aluisioalves123/rf-intercom/hardware/fabrication/assembly/00-overview.png

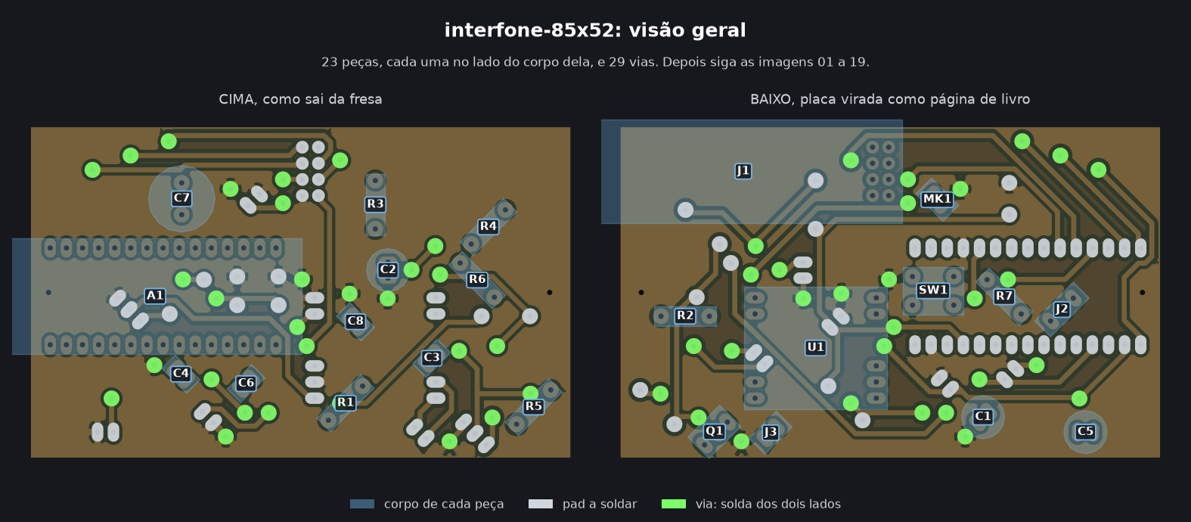
hardware/fabrication/assembly/00-overview.png
