aluisioalves123/rf-intercom/mechanical/stl/button.stl

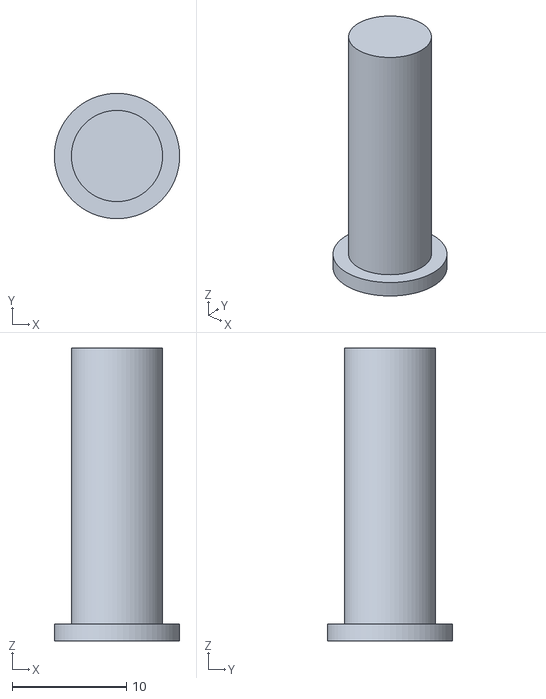
[picture p12: CAD file, 2026-10-19]
mechanical/stl/button.stl
11.0 x 11.0 x 25.7
