aluisioalves123/rf-intercom/mechanical/stl/knob.stl

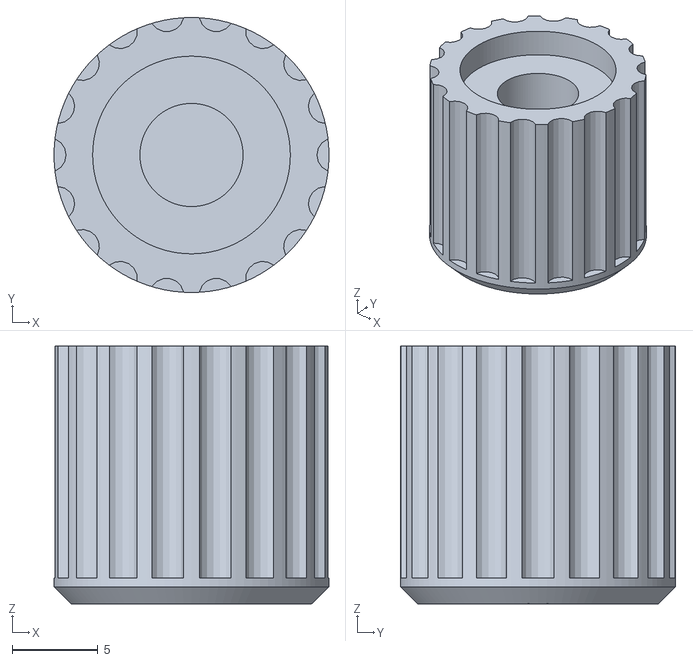
[picture p13: CAD file, 2026-10-19]
mechanical/stl/knob.stl
16.0 x 16.0 x 15.0
