aluisioalves123/rf-intercom/mechanical/stl/base.stl

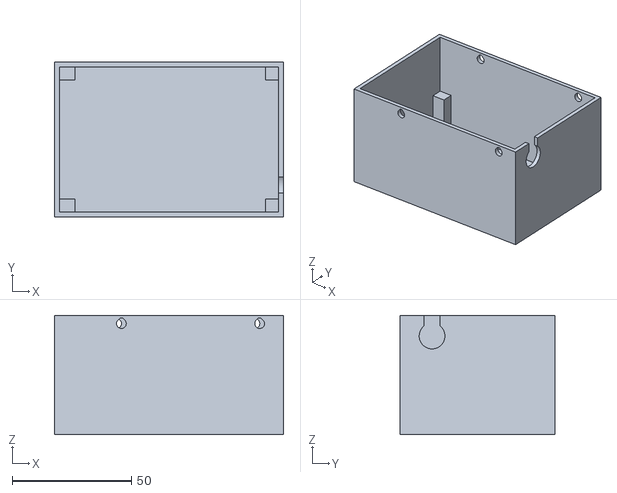
[picture p14: CAD file, 2026-10-19]
mechanical/stl/base.stl
96.1 x 65.0 x 50.1
