aluisioalves123/rf-intercom/mechanical/stl/lid.stl

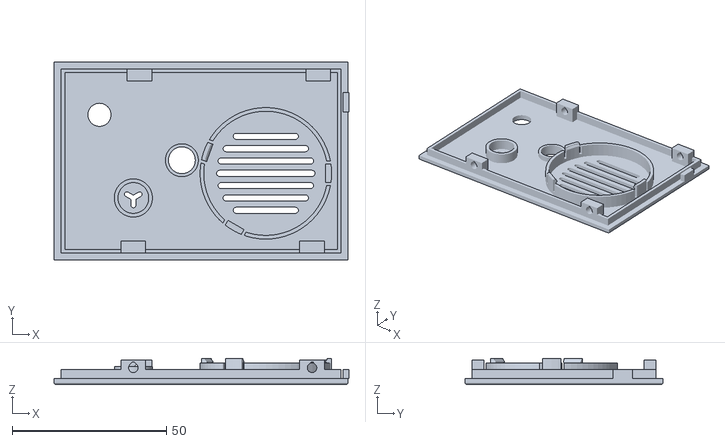
[picture p15: CAD file, 2026-10-19]
mechanical/stl/lid.stl
95.8 x 64.4 x 8.60
