aluisioalves123/rf-intercom/mechanical/pcb3d.scad

// 3D board generated from KiCad (simplified). Origin: bottom-left corner, B side at z = 0, F side at z = 1.6
RADIO_MODULE_HEIGHT = 18.0;
board_length = 85.00; board_width = 52.00; board_thickness = 1.6;
module pcb3d() {
  difference() {
    color("#1f5f2a") cube([board_length, board_width, board_thickness]);
    translate([31.45, 42.3, -1]) cylinder(d = 0.8, h = 4, $fn = 12);
    translate([38.6, 33.0, -1]) cylinder(d = 0.8, h = 4, $fn = 12);
    translate([36.06, 33.0, -1]) cylinder(d = 0.8, h = 4, $fn = 12);
    translate([33.52, 33.0, -1]) cylinder(d = 0.8, h = 4, $fn = 12);
    translate([30.98, 33.0, -1]) cylinder(d = 0.8, h = 4, $fn = 12);
    translate([28.44, 33.0, -1]) cylinder(d = 0.8, h = 4, $fn = 12);
    translate([25.9, 33.0, -1]) cylinder(d = 0.8, h = 4, $fn = 12);
    translate([23.36, 33.0, -1]) cylinder(d = 0.8, h = 4, $fn = 12);
    translate([20.82, 33.0, -1]) cylinder(d = 0.8, h = 4, $fn = 12);
    translate([18.28, 33.0, -1]) cylinder(d = 0.8, h = 4, $fn = 12);
    translate([15.74, 33.0, -1]) cylinder(d = 0.8, h = 4, $fn = 12);
    translate([13.2, 33.0, -1]) cylinder(d = 0.8, h = 4, $fn = 12);
    translate([10.66, 33.0, -1]) cylinder(d = 0.8, h = 4, $fn = 12);
    translate([8.12, 33.0, -1]) cylinder(d = 0.8, h = 4, $fn = 12);
    translate([5.58, 33.0, -1]) cylinder(d = 0.8, h = 4, $fn = 12);
    translate([3.04, 33.0, -1]) cylinder(d = 0.8, h = 4, $fn = 12);
    translate([3.04, 17.76, -1]) cylinder(d = 0.8, h = 4, $fn = 12);
    translate([5.58, 17.76, -1]) cylinder(d = 0.8, h = 4, $fn = 12);
    translate([8.12, 17.76, -1]) cylinder(d = 0.8, h = 4, $fn = 12);
    translate([10.66, 17.76, -1]) cylinder(d = 0.8, h = 4, $fn = 12);
    translate([13.2, 17.76, -1]) cylinder(d = 0.8, h = 4, $fn = 12);
    translate([15.74, 17.76, -1]) cylinder(d = 0.8, h = 4, $fn = 12);
    translate([18.28, 17.76, -1]) cylinder(d = 0.8, h = 4, $fn = 12);
    translate([20.82, 17.76, -1]) cylinder(d = 0.8, h = 4, $fn = 12);
    translate([23.36, 17.76, -1]) cylinder(d = 0.8, h = 4, $fn = 12);
    translate([25.9, 17.76, -1]) cylinder(d = 0.8, h = 4, $fn = 12);
    translate([28.44, 17.76, -1]) cylinder(d = 0.8, h = 4, $fn = 12);
    translate([30.98, 17.76, -1]) cylinder(d = 0.8, h = 4, $fn = 12);
    translate([33.52, 17.76, -1]) cylinder(d = 0.8, h = 4, $fn = 12);
    translate([36.06, 17.76, -1]) cylinder(d = 0.8, h = 4, $fn = 12);
    translate([38.6, 17.76, -1]) cylinder(d = 0.8, h = 4, $fn = 12);
    translate([2.775, 26.0, -1]) cylinder(d = 0.8, h = 4, $fn = 12);
    translate([23.75, 38.25, -1]) cylinder(d = 0.8, h = 4, $fn = 12);
    translate([23.75, 43.25, -1]) cylinder(d = 0.8, h = 4, $fn = 12);
    translate([74.75, 39.0, -1]) cylinder(d = 0.8, h = 4, $fn = 12);
    translate([69.362, 33.612, -1]) cylinder(d = 0.8, h = 4, $fn = 12);
    translate([62.25, 14.75, -1]) cylinder(d = 0.8, h = 4, $fn = 12);
    translate([64.018, 16.518, -1]) cylinder(d = 0.8, h = 4, $fn = 12);
    translate([19.45, 14.55, -1]) cylinder(d = 0.8, h = 4, $fn = 12);
    translate([33.0, 10.75, -1]) cylinder(d = 0.8, h = 4, $fn = 12);
    translate([34.768, 12.518, -1]) cylinder(d = 0.8, h = 4, $fn = 12);
    translate([73.0, 25.25, -1]) cylinder(d = 0.8, h = 4, $fn = 12);
    translate([67.612, 30.638, -1]) cylinder(d = 0.8, h = 4, $fn = 12);
    translate([65.95, 2.55, -1]) cylinder(d = 0.8, h = 4, $fn = 12);
    translate([54.25, 36.0, -1]) cylinder(d = 0.8, h = 4, $fn = 12);
    translate([54.25, 43.62, -1]) cylinder(d = 0.8, h = 4, $fn = 12);
    translate([56.25, 30.75, -1]) cylinder(d = 0.8, h = 4, $fn = 12);
    translate([56.25, 28.25, -1]) cylinder(d = 0.8, h = 4, $fn = 12);
    translate([81.725, 26.0, -1]) cylinder(d = 0.8, h = 4, $fn = 12);
    translate([50.2, 25.8, -1]) cylinder(d = 0.8, h = 4, $fn = 12);
    translate([30.7, 3.3, -1]) cylinder(d = 0.8, h = 4, $fn = 12);
    translate([24.5, 12.25, -1]) cylinder(d = 0.8, h = 4, $fn = 12);
    translate([22.732, 14.018, -1]) cylinder(d = 0.8, h = 4, $fn = 12);
    translate([52.25, 11.25, -1]) cylinder(d = 0.8, h = 4, $fn = 12);
    translate([46.862, 5.862, -1]) cylinder(d = 0.8, h = 4, $fn = 12);
    translate([56.2, 25.05, -1]) cylinder(d = 0.8, h = 4, $fn = 12);
    translate([76.5, 5.25, -1]) cylinder(d = 0.8, h = 4, $fn = 12);
    translate([81.888, 10.638, -1]) cylinder(d = 0.8, h = 4, $fn = 12);
    translate([42.7, 28.05, -1]) cylinder(d = 0.8, h = 4, $fn = 12);
    translate([52.0, 20.5, -1]) cylinder(d = 0.8, h = 4, $fn = 12);
    translate([50.232, 22.268, -1]) cylinder(d = 0.8, h = 4, $fn = 12);
    translate([32.5, 24.0, -1]) cylinder(d = 0.8, h = 4, $fn = 12);
    translate([39.0, 24.0, -1]) cylinder(d = 0.8, h = 4, $fn = 12);
    translate([32.5, 28.5, -1]) cylinder(d = 0.8, h = 4, $fn = 12);
    translate([39.0, 28.5, -1]) cylinder(d = 0.8, h = 4, $fn = 12);
    translate([71.0, 22.25, -1]) cylinder(d = 0.8, h = 4, $fn = 12);
    translate([78.62, 22.25, -1]) cylinder(d = 0.8, h = 4, $fn = 12);
    translate([71.75, 2.0, -1]) cylinder(d = 0.8, h = 4, $fn = 12);
    translate([69.954, 3.796, -1]) cylinder(d = 0.8, h = 4, $fn = 12);
    translate([68.158, 5.592, -1]) cylinder(d = 0.8, h = 4, $fn = 12);
    translate([27.25, 28.0, -1]) cylinder(d = 0.8, h = 4, $fn = 12);
    translate([21.862, 22.612, -1]) cylinder(d = 0.8, h = 4, $fn = 12);
    translate([44.7, 9.35, -1]) cylinder(d = 0.8, h = 4, $fn = 12);
    translate([44.7, 11.89, -1]) cylinder(d = 0.8, h = 4, $fn = 12);
    translate([44.7, 14.43, -1]) cylinder(d = 0.8, h = 4, $fn = 12);
    translate([44.7, 22.61, -1]) cylinder(d = 0.8, h = 4, $fn = 12);
    translate([44.7, 25.15, -1]) cylinder(d = 0.8, h = 4, $fn = 12);
    translate([63.8, 9.35, -1]) cylinder(d = 0.8, h = 4, $fn = 12);
    translate([63.8, 11.89, -1]) cylinder(d = 0.8, h = 4, $fn = 12);
    translate([63.8, 22.61, -1]) cylinder(d = 0.8, h = 4, $fn = 12);
    translate([63.8, 25.15, -1]) cylinder(d = 0.8, h = 4, $fn = 12);
    translate([17.25, 21.5, -1]) cylinder(d = 0.8, h = 4, $fn = 12);
    translate([15.454, 23.296, -1]) cylinder(d = 0.8, h = 4, $fn = 12);
    translate([13.658, 25.092, -1]) cylinder(d = 0.8, h = 4, $fn = 12);
    translate([13.0, 4.0, -1]) cylinder(d = 0.8, h = 4, $fn = 12);
    translate([10.5, 4.0, -1]) cylinder(d = 0.8, h = 4, $fn = 12);
    translate([42.75, 41.25, -1]) cylinder(d = 0.8, h = 4, $fn = 12);
    translate([45.29, 41.25, -1]) cylinder(d = 0.8, h = 4, $fn = 12);
    translate([42.75, 43.79, -1]) cylinder(d = 0.8, h = 4, $fn = 12);
    translate([45.29, 43.79, -1]) cylinder(d = 0.8, h = 4, $fn = 12);
    translate([42.75, 46.33, -1]) cylinder(d = 0.8, h = 4, $fn = 12);
    translate([45.29, 46.33, -1]) cylinder(d = 0.8, h = 4, $fn = 12);
    translate([42.75, 48.87, -1]) cylinder(d = 0.8, h = 4, $fn = 12);
    translate([45.29, 48.87, -1]) cylinder(d = 0.8, h = 4, $fn = 12);
    translate([27.0, 7.25, -1]) cylinder(d = 0.8, h = 4, $fn = 12);
    translate([28.768, 5.482, -1]) cylinder(d = 0.8, h = 4, $fn = 12);
    translate([36.0, 41.5, -1]) cylinder(d = 0.8, h = 4, $fn = 12);
    translate([34.204, 39.704, -1]) cylinder(d = 0.8, h = 4, $fn = 12);
    translate([62.25, 3.0, -1]) cylinder(d = 0.8, h = 4, $fn = 12);
    translate([60.454, 4.796, -1]) cylinder(d = 0.8, h = 4, $fn = 12);
    translate([29.2, 25.05, -1]) cylinder(d = 0.8, h = 4, $fn = 12);
    translate([39.7, 43.8, -1]) cylinder(d = 0.8, h = 4, $fn = 12);
    translate([48.7, 46.8, -1]) cylinder(d = 0.8, h = 4, $fn = 12);
    translate([23.95, 28.05, -1]) cylinder(d = 0.8, h = 4, $fn = 12);
    translate([21.7, 49.8, -1]) cylinder(d = 0.8, h = 4, $fn = 12);
    translate([15.7, 47.55, -1]) cylinder(d = 0.8, h = 4, $fn = 12);
    translate([9.7, 45.3, -1]) cylinder(d = 0.8, h = 4, $fn = 12);
    translate([43.45, 17.55, -1]) cylinder(d = 0.8, h = 4, $fn = 12);
    translate([12.7, 9.3, -1]) cylinder(d = 0.8, h = 4, $fn = 12);
    translate([33.7, 7.05, -1]) cylinder(d = 0.8, h = 4, $fn = 12);
    translate([28.45, 12.3, -1]) cylinder(d = 0.8, h = 4, $fn = 12);
    translate([41.95, 20.55, -1]) cylinder(d = 0.8, h = 4, $fn = 12);
    translate([59.95, 29.55, -1]) cylinder(d = 0.8, h = 4, $fn = 12);
    translate([63.7, 33.3, -1]) cylinder(d = 0.8, h = 4, $fn = 12);
    translate([72.7, 6.3, -1]) cylinder(d = 0.8, h = 4, $fn = 12);
    translate([73.45, 17.55, -1]) cylinder(d = 0.8, h = 4, $fn = 12);
    translate([64.45, 28.8, -1]) cylinder(d = 0.8, h = 4, $fn = 12);
    translate([39.7, 40.05, -1]) cylinder(d = 0.8, h = 4, $fn = 12);
    translate([78.7, 10.05, -1]) cylinder(d = 0.8, h = 4, $fn = 12);
    translate([67.45, 16.8, -1]) cylinder(d = 0.8, h = 4, $fn = 12);
    translate([37.45, 7.05, -1]) cylinder(d = 0.8, h = 4, $fn = 12);
    translate([48.7, 8.55, -1]) cylinder(d = 0.8, h = 4, $fn = 12);
  }
  color("#c98a3a") translate([0, 0, 1.6]) linear_extrude(0.04) union() {
    hull() { translate([35.95, 41.55]) circle(d = 0.8, $fn = 10); translate([35.65, 41.85]) circle(d = 0.8, $fn = 10); }
    hull() { translate([40.15, 37.5]) circle(d = 0.8, $fn = 10); translate([43.0, 40.35]) circle(d = 0.8, $fn = 10); }
    hull() { translate([3.1, 14.55]) circle(d = 0.8, $fn = 10); translate([19.45, 14.55]) circle(d = 0.8, $fn = 10); }
    hull() { translate([54.25, 20.25]) circle(d = 0.8, $fn = 10); translate([46.15, 12.15]) circle(d = 0.8, $fn = 10); }
    hull() { translate([65.95, 2.55]) circle(d = 0.8, $fn = 10); translate([67.75, 4.35]) circle(d = 0.8, $fn = 10); }
    hull() { translate([31.9, 25.05]) circle(d = 0.8, $fn = 10); translate([38.35, 25.05]) circle(d = 0.8, $fn = 10); }
    hull() { translate([29.2, 25.05]) circle(d = 0.8, $fn = 10); translate([31.9, 25.05]) circle(d = 0.8, $fn = 10); }
    hull() { translate([39.7, 43.8]) circle(d = 0.8, $fn = 10); translate([41.8, 43.8]) circle(d = 0.8, $fn = 10); }
    hull() { translate([48.7, 46.8]) circle(d = 0.8, $fn = 10); translate([46.15, 44.25]) circle(d = 0.8, $fn = 10); }
    hull() { translate([23.95, 28.05]) circle(d = 0.8, $fn = 10); translate([26.05, 28.05]) circle(d = 0.8, $fn = 10); }
    hull() { translate([46.9, 47.85]) circle(d = 0.8, $fn = 10); translate([46.0, 46.95]) circle(d = 0.8, $fn = 10); }
    hull() { translate([21.7, 49.8]) circle(d = 0.8, $fn = 10); translate([22.6, 50.7]) circle(d = 0.8, $fn = 10); }
    hull() { translate([46.15, 50.7]) circle(d = 0.8, $fn = 10); translate([47.2, 49.65]) circle(d = 0.8, $fn = 10); }
    hull() { translate([47.2, 48.3]) circle(d = 0.8, $fn = 10); translate([46.9, 48.0]) circle(d = 0.8, $fn = 10); }
    hull() { translate([22.6, 50.7]) circle(d = 0.8, $fn = 10); translate([46.15, 50.7]) circle(d = 0.8, $fn = 10); }
    hull() { translate([46.9, 48.0]) circle(d = 0.8, $fn = 10); translate([46.9, 47.85]) circle(d = 0.8, $fn = 10); }
    hull() { translate([47.2, 49.65]) circle(d = 0.8, $fn = 10); translate([47.2, 48.3]) circle(d = 0.8, $fn = 10); }
    hull() { translate([40.75, 47.55]) circle(d = 0.8, $fn = 10); translate([41.8, 48.6]) circle(d = 0.8, $fn = 10); }
    hull() { translate([15.7, 47.55]) circle(d = 0.8, $fn = 10); translate([40.75, 47.55]) circle(d = 0.8, $fn = 10); }
    hull() { translate([9.7, 45.3]) circle(d = 0.8, $fn = 10); translate([23.5, 45.3]) circle(d = 0.8, $fn = 10); }
    hull() { translate([23.5, 45.3]) circle(d = 0.8, $fn = 10); translate([24.25, 46.05]) circle(d = 0.8, $fn = 10); }
    hull() { translate([24.25, 46.05]) circle(d = 0.8, $fn = 10); translate([41.8, 46.05]) circle(d = 0.8, $fn = 10); }
    hull() { translate([12.7, 9.3]) circle(d = 0.8, $fn = 10); translate([12.7, 5.4]) circle(d = 0.8, $fn = 10); }
    hull() { translate([47.05, 21.15]) circle(d = 0.8, $fn = 10); translate([47.05, 39.0]) circle(d = 0.8, $fn = 10); }
    hull() { translate([47.05, 39.0]) circle(d = 0.8, $fn = 10); translate([45.7, 40.35]) circle(d = 0.8, $fn = 10); }
    hull() { translate([43.45, 17.55]) circle(d = 0.8, $fn = 10); translate([47.05, 21.15]) circle(d = 0.8, $fn = 10); }
    hull() { translate([28.45, 12.3]) circle(d = 0.8, $fn = 10); translate([33.7, 7.05]) circle(d = 0.8, $fn = 10); }
    hull() { translate([41.95, 20.55]) circle(d = 0.8, $fn = 10); translate([43.45, 22.05]) circle(d = 0.8, $fn = 10); }
    hull() { translate([63.7, 33.3]) circle(d = 0.8, $fn = 10); translate([59.95, 29.55]) circle(d = 0.8, $fn = 10); }
    hull() { translate([72.7, 6.3]) circle(d = 0.8, $fn = 10); translate([72.7, 3.15]) circle(d = 0.8, $fn = 10); }
    hull() { translate([72.7, 28.5]) circle(d = 0.8, $fn = 10); translate([64.75, 28.5]) circle(d = 0.8, $fn = 10); }
    hull() { translate([64.75, 28.5]) circle(d = 0.8, $fn = 10); translate([64.45, 28.8]) circle(d = 0.8, $fn = 10); }
    hull() { translate([38.95, 39.3]) circle(d = 0.8, $fn = 10); translate([35.5, 39.3]) circle(d = 0.8, $fn = 10); }
    hull() { translate([39.7, 40.05]) circle(d = 0.8, $fn = 10); translate([38.95, 39.3]) circle(d = 0.8, $fn = 10); }
    hull() { translate([77.65, 21.75]) circle(d = 0.8, $fn = 10); translate([73.45, 17.55]) circle(d = 0.8, $fn = 10); }
    hull() { translate([77.95, 23.25]) circle(d = 0.8, $fn = 10); translate([72.7, 28.5]) circle(d = 0.8, $fn = 10); }
    hull() { translate([70.3, 10.05]) circle(d = 0.8, $fn = 10); translate([78.7, 10.05]) circle(d = 0.8, $fn = 10); }
    hull() { translate([67.45, 16.8]) circle(d = 0.8, $fn = 10); translate([70.3, 13.95]) circle(d = 0.8, $fn = 10); }
    hull() { translate([70.3, 13.95]) circle(d = 0.8, $fn = 10); translate([70.3, 5.1]) circle(d = 0.8, $fn = 10); }
    hull() { translate([37.45, 7.05]) circle(d = 0.8, $fn = 10); translate([35.35, 4.95]) circle(d = 0.8, $fn = 10); }
    hull() { translate([29.95, 7.65]) circle(d = 0.8, $fn = 10); translate([28.3, 7.65]) circle(d = 0.8, $fn = 10); }
    hull() { translate([52.75, 8.55]) circle(d = 0.8, $fn = 10); translate([48.7, 8.55]) circle(d = 0.8, $fn = 10); }
    hull() { translate([65.5, 21.3]) circle(d = 0.8, $fn = 10); translate([52.75, 8.55]) circle(d = 0.8, $fn = 10); }
    hull() { translate([35.35, 4.95]) circle(d = 0.8, $fn = 10); translate([32.65, 4.95]) circle(d = 0.8, $fn = 10); }
    hull() { translate([32.65, 4.95]) circle(d = 0.8, $fn = 10); translate([29.95, 7.65]) circle(d = 0.8, $fn = 10); }
    hull() { translate([70.3, 21.3]) circle(d = 0.8, $fn = 10); translate([65.5, 21.3]) circle(d = 0.8, $fn = 10); }
    hull() { translate([20.65, 22.35]) circle(d = 0.8, $fn = 10); translate([18.4, 22.35]) circle(d = 0.8, $fn = 10); }
    hull() { translate([43.45, 9.9]) circle(d = 0.8, $fn = 10); translate([40.45, 12.9]) circle(d = 0.8, $fn = 10); }
    hull() { translate([40.45, 19.05]) circle(d = 0.8, $fn = 10); translate([37.6, 21.9]) circle(d = 0.8, $fn = 10); }
    hull() { translate([17.65, 24.75]) circle(d = 0.8, $fn = 10); translate([16.75, 23.85]) circle(d = 0.8, $fn = 10); }
    hull() { translate([37.6, 21.9]) circle(d = 0.8, $fn = 10); translate([25.6, 21.9]) circle(d = 0.8, $fn = 10); }
    hull() { translate([22.75, 24.75]) circle(d = 0.8, $fn = 10); translate([17.65, 24.75]) circle(d = 0.8, $fn = 10); }
    hull() { translate([40.45, 12.9]) circle(d = 0.8, $fn = 10); translate([40.45, 19.05]) circle(d = 0.8, $fn = 10); }
    hull() { translate([25.6, 21.9]) circle(d = 0.8, $fn = 10); translate([22.75, 24.75]) circle(d = 0.8, $fn = 10); }
    hull() { translate([61.3, 7.05]) circle(d = 0.8, $fn = 10); translate([61.3, 6.0]) circle(d = 0.8, $fn = 10); }
    hull() { translate([62.8, 8.55]) circle(d = 0.8, $fn = 10); translate([61.3, 7.05]) circle(d = 0.8, $fn = 10); }
    hull() { translate([65.05, 11.4]) circle(d = 0.8, $fn = 10); translate([66.25, 10.2]) circle(d = 0.8, $fn = 10); }
    hull() { translate([66.25, 7.35]) circle(d = 0.8, $fn = 10); translate([63.1, 4.2]) circle(d = 0.8, $fn = 10); }
    hull() { translate([66.25, 10.2]) circle(d = 0.8, $fn = 10); translate([66.25, 7.35]) circle(d = 0.8, $fn = 10); }
    translate([31.45, 42.3]) circle(d = 2.5, $fn = 16);
    translate([38.6, 33.0]) rotate(-90.0) hull() { translate([0.6, 0]) circle(d = 1.8, $fn = 12); translate([-0.6, 0]) circle(d = 1.8, $fn = 12); }
    translate([36.06, 33.0]) rotate(-90.0) hull() { translate([0.6, 0]) circle(d = 1.8, $fn = 12); translate([-0.6, 0]) circle(d = 1.8, $fn = 12); }
    translate([33.52, 33.0]) rotate(-90.0) hull() { translate([0.6, 0]) circle(d = 1.8, $fn = 12); translate([-0.6, 0]) circle(d = 1.8, $fn = 12); }
    translate([30.98, 33.0]) rotate(-90.0) hull() { translate([0.6, 0]) circle(d = 1.8, $fn = 12); translate([-0.6, 0]) circle(d = 1.8, $fn = 12); }
    translate([28.44, 33.0]) rotate(-90.0) hull() { translate([0.6, 0]) circle(d = 1.8, $fn = 12); translate([-0.6, 0]) circle(d = 1.8, $fn = 12); }
    translate([25.9, 33.0]) rotate(-90.0) hull() { translate([0.6, 0]) circle(d = 1.8, $fn = 12); translate([-0.6, 0]) circle(d = 1.8, $fn = 12); }
    translate([23.36, 33.0]) rotate(-90.0) hull() { translate([0.6, 0]) circle(d = 1.8, $fn = 12); translate([-0.6, 0]) circle(d = 1.8, $fn = 12); }
    translate([20.82, 33.0]) rotate(-90.0) hull() { translate([0.6, 0]) circle(d = 1.8, $fn = 12); translate([-0.6, 0]) circle(d = 1.8, $fn = 12); }
    translate([18.28, 33.0]) rotate(-90.0) hull() { translate([0.6, 0]) circle(d = 1.8, $fn = 12); translate([-0.6, 0]) circle(d = 1.8, $fn = 12); }
    translate([15.74, 33.0]) rotate(-90.0) hull() { translate([0.6, 0]) circle(d = 1.8, $fn = 12); translate([-0.6, 0]) circle(d = 1.8, $fn = 12); }
    translate([13.2, 33.0]) rotate(-90.0) hull() { translate([0.6, 0]) circle(d = 1.8, $fn = 12); translate([-0.6, 0]) circle(d = 1.8, $fn = 12); }
    translate([10.66, 33.0]) rotate(-90.0) hull() { translate([0.6, 0]) circle(d = 1.8, $fn = 12); translate([-0.6, 0]) circle(d = 1.8, $fn = 12); }
    translate([8.12, 33.0]) rotate(-90.0) hull() { translate([0.6, 0]) circle(d = 1.8, $fn = 12); translate([-0.6, 0]) circle(d = 1.8, $fn = 12); }
    translate([5.58, 33.0]) rotate(-90.0) hull() { translate([0.6, 0]) circle(d = 1.8, $fn = 12); translate([-0.6, 0]) circle(d = 1.8, $fn = 12); }
    translate([3.04, 33.0]) rotate(-90.0) hull() { translate([0.6, 0]) circle(d = 1.8, $fn = 12); translate([-0.6, 0]) circle(d = 1.8, $fn = 12); }
    translate([3.04, 17.76]) rotate(-90.0) hull() { translate([0.6, 0]) circle(d = 1.8, $fn = 12); translate([-0.6, 0]) circle(d = 1.8, $fn = 12); }
    translate([5.58, 17.76]) rotate(-90.0) hull() { translate([0.6, 0]) circle(d = 1.8, $fn = 12); translate([-0.6, 0]) circle(d = 1.8, $fn = 12); }
    translate([8.12, 17.76]) rotate(-90.0) hull() { translate([0.6, 0]) circle(d = 1.8, $fn = 12); translate([-0.6, 0]) circle(d = 1.8, $fn = 12); }
    translate([10.66, 17.76]) rotate(-90.0) hull() { translate([0.6, 0]) circle(d = 1.8, $fn = 12); translate([-0.6, 0]) circle(d = 1.8, $fn = 12); }
    translate([13.2, 17.76]) rotate(-90.0) hull() { translate([0.6, 0]) circle(d = 1.8, $fn = 12); translate([-0.6, 0]) circle(d = 1.8, $fn = 12); }
    translate([15.74, 17.76]) rotate(-90.0) hull() { translate([0.6, 0]) circle(d = 1.8, $fn = 12); translate([-0.6, 0]) circle(d = 1.8, $fn = 12); }
    translate([18.28, 17.76]) rotate(-90.0) hull() { translate([0.6, 0]) circle(d = 1.8, $fn = 12); translate([-0.6, 0]) circle(d = 1.8, $fn = 12); }
    translate([20.82, 17.76]) rotate(-90.0) hull() { translate([0.6, 0]) circle(d = 1.8, $fn = 12); translate([-0.6, 0]) circle(d = 1.8, $fn = 12); }
    translate([23.36, 17.76]) rotate(-90.0) hull() { translate([0.6, 0]) circle(d = 1.8, $fn = 12); translate([-0.6, 0]) circle(d = 1.8, $fn = 12); }
    translate([25.9, 17.76]) rotate(-90.0) hull() { translate([0.6, 0]) circle(d = 1.8, $fn = 12); translate([-0.6, 0]) circle(d = 1.8, $fn = 12); }
    translate([28.44, 17.76]) rotate(-90.0) hull() { translate([0.6, 0]) circle(d = 1.8, $fn = 12); translate([-0.6, 0]) circle(d = 1.8, $fn = 12); }
    translate([30.98, 17.76]) rotate(-90.0) hull() { translate([0.6, 0]) circle(d = 1.8, $fn = 12); translate([-0.6, 0]) circle(d = 1.8, $fn = 12); }
    translate([33.52, 17.76]) rotate(-90.0) hull() { translate([0.6, 0]) circle(d = 1.8, $fn = 12); translate([-0.6, 0]) circle(d = 1.8, $fn = 12); }
    translate([36.06, 17.76]) rotate(-90.0) hull() { translate([0.6, 0]) circle(d = 1.8, $fn = 12); translate([-0.6, 0]) circle(d = 1.8, $fn = 12); }
    translate([38.6, 17.76]) rotate(-90.0) hull() { translate([0.6, 0]) circle(d = 1.8, $fn = 12); translate([-0.6, 0]) circle(d = 1.8, $fn = 12); }
    translate([2.775, 26.0]) circle(d = 0.8, $fn = 16);
    translate([23.75, 38.25]) circle(d = 2.5, $fn = 16);
    translate([23.75, 43.25]) circle(d = 2.5, $fn = 16);
    translate([74.75, 39.0]) circle(d = 2.5, $fn = 16);
    translate([69.362, 33.612]) circle(d = 2.5, $fn = 16);
    translate([62.25, 14.75]) rotate(45.0) hull() { translate([0, 0.6]) circle(d = 1.8, $fn = 12); translate([0, -0.6]) circle(d = 1.8, $fn = 12); }
    translate([64.018, 16.518]) rotate(45.0) hull() { translate([0, 0.6]) circle(d = 1.8, $fn = 12); translate([0, -0.6]) circle(d = 1.8, $fn = 12); }
    translate([19.45, 14.55]) circle(d = 2.5, $fn = 16);
    translate([33.0, 10.75]) rotate(45.0) hull() { translate([0, 0.6]) circle(d = 1.8, $fn = 12); translate([0, -0.6]) circle(d = 1.8, $fn = 12); }
    translate([34.768, 12.518]) rotate(45.0) hull() { translate([0, 0.6]) circle(d = 1.8, $fn = 12); translate([0, -0.6]) circle(d = 1.8, $fn = 12); }
    translate([73.0, 25.25]) circle(d = 2.5, $fn = 16);
    translate([67.612, 30.638]) circle(d = 2.5, $fn = 16);
    translate([65.95, 2.55]) circle(d = 2.5, $fn = 16);
    translate([54.25, 36.0]) circle(d = 2.5, $fn = 16);
    translate([54.25, 43.62]) circle(d = 2.5, $fn = 16);
    translate([56.25, 30.75]) rotate(-90.0) hull() { translate([0, 0.6]) circle(d = 1.8, $fn = 12); translate([0, -0.6]) circle(d = 1.8, $fn = 12); }
    translate([56.25, 28.25]) rotate(-90.0) hull() { translate([0, 0.6]) circle(d = 1.8, $fn = 12); translate([0, -0.6]) circle(d = 1.8, $fn = 12); }
    translate([81.725, 26.0]) circle(d = 0.8, $fn = 16);
    translate([50.2, 25.8]) circle(d = 2.5, $fn = 16);
    translate([30.7, 3.3]) circle(d = 2.5, $fn = 16);
    translate([24.5, 12.25]) rotate(135.0) hull() { translate([0, 0.6]) circle(d = 1.8, $fn = 12); translate([0, -0.6]) circle(d = 1.8, $fn = 12); }
    translate([22.732, 14.018]) rotate(135.0) hull() { translate([0, 0.6]) circle(d = 1.8, $fn = 12); translate([0, -0.6]) circle(d = 1.8, $fn = 12); }
    translate([52.25, 11.25]) circle(d = 2.5, $fn = 16);
    translate([46.862, 5.862]) circle(d = 2.5, $fn = 16);
    translate([56.2, 25.05]) circle(d = 2.5, $fn = 16);
    translate([76.5, 5.25]) circle(d = 2.5, $fn = 16);
    translate([81.888, 10.638]) circle(d = 2.5, $fn = 16);
    translate([42.7, 28.05]) circle(d = 2.5, $fn = 16);
    translate([52.0, 20.5]) rotate(135.0) hull() { translate([0, 0.6]) circle(d = 1.8, $fn = 12); translate([0, -0.6]) circle(d = 1.8, $fn = 12); }
    translate([50.232, 22.268]) rotate(135.0) hull() { translate([0, 0.6]) circle(d = 1.8, $fn = 12); translate([0, -0.6]) circle(d = 1.8, $fn = 12); }
    translate([32.5, 24.0]) circle(d = 2.5, $fn = 16);
    translate([39.0, 24.0]) circle(d = 2.5, $fn = 16);
    translate([32.5, 28.5]) circle(d = 2.5, $fn = 16);
    translate([39.0, 28.5]) circle(d = 2.5, $fn = 16);
    translate([71.0, 22.25]) circle(d = 2.5, $fn = 16);
    translate([78.62, 22.25]) circle(d = 2.5, $fn = 16);
    translate([71.75, 2.0]) rotate(135.0) hull() { translate([0, 0.6]) circle(d = 1.8, $fn = 12); translate([0, -0.6]) circle(d = 1.8, $fn = 12); }
    translate([69.954, 3.796]) rotate(135.0) hull() { translate([0, 0.6]) circle(d = 1.8, $fn = 12); translate([0, -0.6]) circle(d = 1.8, $fn = 12); }
    translate([68.158, 5.592]) rotate(135.0) hull() { translate([0, 0.6]) circle(d = 1.8, $fn = 12); translate([0, -0.6]) circle(d = 1.8, $fn = 12); }
    translate([27.25, 28.0]) circle(d = 2.5, $fn = 16);
    translate([21.862, 22.612]) circle(d = 2.5, $fn = 16);
    translate([44.7, 9.35]) rotate(90.0) hull() { translate([0, 0.6]) circle(d = 1.8, $fn = 12); translate([0, -0.6]) circle(d = 1.8, $fn = 12); }
    translate([44.7, 11.89]) rotate(90.0) hull() { translate([0, 0.6]) circle(d = 1.8, $fn = 12); translate([0, -0.6]) circle(d = 1.8, $fn = 12); }
    translate([44.7, 14.43]) rotate(90.0) hull() { translate([0, 0.6]) circle(d = 1.8, $fn = 12); translate([0, -0.6]) circle(d = 1.8, $fn = 12); }
    translate([44.7, 22.61]) rotate(90.0) hull() { translate([0, 0.6]) circle(d = 1.8, $fn = 12); translate([0, -0.6]) circle(d = 1.8, $fn = 12); }
    translate([44.7, 25.15]) rotate(90.0) hull() { translate([0, 0.6]) circle(d = 1.8, $fn = 12); translate([0, -0.6]) circle(d = 1.8, $fn = 12); }
    translate([63.8, 9.35]) rotate(90.0) hull() { translate([0, 0.6]) circle(d = 1.8, $fn = 12); translate([0, -0.6]) circle(d = 1.8, $fn = 12); }
    translate([63.8, 11.89]) rotate(90.0) hull() { translate([0, 0.6]) circle(d = 1.8, $fn = 12); translate([0, -0.6]) circle(d = 1.8, $fn = 12); }
    translate([63.8, 22.61]) rotate(90.0) hull() { translate([0, 0.6]) circle(d = 1.8, $fn = 12); translate([0, -0.6]) circle(d = 1.8, $fn = 12); }
    translate([63.8, 25.15]) rotate(90.0) hull() { translate([0, 0.6]) circle(d = 1.8, $fn = 12); translate([0, -0.6]) circle(d = 1.8, $fn = 12); }
    translate([17.25, 21.5]) rotate(45.0) hull() { translate([0.6, 0]) circle(d = 1.8, $fn = 12); translate([-0.6, 0]) circle(d = 1.8, $fn = 12); }
    translate([15.454, 23.296]) rotate(45.0) hull() { translate([0.6, 0]) circle(d = 1.8, $fn = 12); translate([-0.6, 0]) circle(d = 1.8, $fn = 12); }
    translate([13.658, 25.092]) rotate(45.0) hull() { translate([0.6, 0]) circle(d = 1.8, $fn = 12); translate([-0.6, 0]) circle(d = 1.8, $fn = 12); }
    translate([13.0, 4.0]) rotate(180.0) hull() { translate([0, 0.6]) circle(d = 1.8, $fn = 12); translate([0, -0.6]) circle(d = 1.8, $fn = 12); }
    translate([10.5, 4.0]) rotate(180.0) hull() { translate([0, 0.6]) circle(d = 1.8, $fn = 12); translate([0, -0.6]) circle(d = 1.8, $fn = 12); }
    translate([42.75, 41.25]) circle(d = 2.0, $fn = 16);
    translate([45.29, 41.25]) circle(d = 2.0, $fn = 16);
    translate([42.75, 43.79]) circle(d = 2.0, $fn = 16);
    translate([45.29, 43.79]) circle(d = 2.0, $fn = 16);
    translate([42.75, 46.33]) circle(d = 2.0, $fn = 16);
    translate([45.29, 46.33]) circle(d = 2.0, $fn = 16);
    translate([42.75, 48.87]) circle(d = 2.0, $fn = 16);
    translate([45.29, 48.87]) circle(d = 2.0, $fn = 16);
    translate([27.0, 7.25]) rotate(-45.0) hull() { translate([0, 0.6]) circle(d = 1.8, $fn = 12); translate([0, -0.6]) circle(d = 1.8, $fn = 12); }
    translate([28.768, 5.482]) rotate(-45.0) hull() { translate([0, 0.6]) circle(d = 1.8, $fn = 12); translate([0, -0.6]) circle(d = 1.8, $fn = 12); }
    translate([36.0, 41.5]) rotate(135.0) hull() { translate([0.6, 0]) circle(d = 1.8, $fn = 12); translate([-0.6, 0]) circle(d = 1.8, $fn = 12); }
    translate([34.204, 39.704]) rotate(135.0) hull() { translate([0.6, 0]) circle(d = 1.8, $fn = 12); translate([-0.6, 0]) circle(d = 1.8, $fn = 12); }
    translate([62.25, 3.0]) rotate(45.0) hull() { translate([0.6, 0]) circle(d = 1.8, $fn = 12); translate([-0.6, 0]) circle(d = 1.8, $fn = 12); }
    translate([60.454, 4.796]) rotate(45.0) hull() { translate([0.6, 0]) circle(d = 1.8, $fn = 12); translate([-0.6, 0]) circle(d = 1.8, $fn = 12); }
    translate([29.2, 25.05]) circle(d = 2.5, $fn = 12);
    translate([39.7, 43.8]) circle(d = 2.5, $fn = 12);
    translate([48.7, 46.8]) circle(d = 2.5, $fn = 12);
    translate([23.95, 28.05]) circle(d = 2.5, $fn = 12);
    translate([21.7, 49.8]) circle(d = 2.5, $fn = 12);
    translate([15.7, 47.55]) circle(d = 2.5, $fn = 12);
    translate([9.7, 45.3]) circle(d = 2.5, $fn = 12);
    translate([43.45, 17.55]) circle(d = 2.5, $fn = 12);
    translate([12.7, 9.3]) circle(d = 2.5, $fn = 12);
    translate([33.7, 7.05]) circle(d = 2.5, $fn = 12);
    translate([28.45, 12.3]) circle(d = 2.5, $fn = 12);
    translate([41.95, 20.55]) circle(d = 2.5, $fn = 12);
    translate([59.95, 29.55]) circle(d = 2.5, $fn = 12);
    translate([63.7, 33.3]) circle(d = 2.5, $fn = 12);
    translate([72.7, 6.3]) circle(d = 2.5, $fn = 12);
    translate([73.45, 17.55]) circle(d = 2.5, $fn = 12);
    translate([64.45, 28.8]) circle(d = 2.5, $fn = 12);
    translate([39.7, 40.05]) circle(d = 2.5, $fn = 12);
    translate([78.7, 10.05]) circle(d = 2.5, $fn = 12);
    translate([67.45, 16.8]) circle(d = 2.5, $fn = 12);
    translate([37.45, 7.05]) circle(d = 2.5, $fn = 12);
    translate([48.7, 8.55]) circle(d = 2.5, $fn = 12);
  }
  color("#c98a3a") translate([0, 0, -0.04]) linear_extrude(0.04) union() {
    hull() { translate([65.95, 2.7]) circle(d = 0.8, $fn = 10); translate([65.95, 2.55]) circle(d = 0.8, $fn = 10); }
    hull() { translate([56.2, 25.05]) circle(d = 0.8, $fn = 10); translate([56.2, 27.45]) circle(d = 0.8, $fn = 10); }
    hull() { translate([33.55, 14.55]) circle(d = 0.8, $fn = 10); translate([35.5, 16.5]) circle(d = 0.8, $fn = 10); }
    hull() { translate([19.45, 14.55]) circle(d = 0.8, $fn = 10); translate([33.55, 14.55]) circle(d = 0.8, $fn = 10); }
    hull() { translate([29.35, 25.2]) circle(d = 0.8, $fn = 10); translate([29.2, 25.05]) circle(d = 0.8, $fn = 10); }
    hull() { translate([28.9, 31.65]) circle(d = 0.8, $fn = 10); translate([29.35, 31.2]) circle(d = 0.8, $fn = 10); }
    hull() { translate([29.35, 31.2]) circle(d = 0.8, $fn = 10); translate([29.35, 25.2]) circle(d = 0.8, $fn = 10); }
    hull() { translate([22.9, 45.45]) circle(d = 0.8, $fn = 10); translate([38.05, 45.45]) circle(d = 0.8, $fn = 10); }
    hull() { translate([16.15, 34.35]) circle(d = 0.8, $fn = 10); translate([16.15, 38.7]) circle(d = 0.8, $fn = 10); }
    hull() { translate([38.05, 45.45]) circle(d = 0.8, $fn = 10); translate([39.7, 43.8]) circle(d = 0.8, $fn = 10); }
    hull() { translate([16.15, 38.7]) circle(d = 0.8, $fn = 10); translate([22.9, 45.45]) circle(d = 0.8, $fn = 10); }
    hull() { translate([48.7, 48.15]) circle(d = 0.8, $fn = 10); translate([48.7, 46.8]) circle(d = 0.8, $fn = 10); }
    hull() { translate([13.6, 34.35]) circle(d = 0.8, $fn = 10); translate([13.6, 37.95]) circle(d = 0.8, $fn = 10); }
    hull() { translate([26.35, 50.7]) circle(d = 0.8, $fn = 10); translate([46.15, 50.7]) circle(d = 0.8, $fn = 10); }
    hull() { translate([46.15, 50.7]) circle(d = 0.8, $fn = 10); translate([48.7, 48.15]) circle(d = 0.8, $fn = 10); }
    hull() { translate([13.6, 37.95]) circle(d = 0.8, $fn = 10); translate([26.35, 50.7]) circle(d = 0.8, $fn = 10); }
    hull() { translate([14.95, 28.05]) circle(d = 0.8, $fn = 10); translate([23.95, 28.05]) circle(d = 0.8, $fn = 10); }
    hull() { translate([11.2, 31.8]) circle(d = 0.8, $fn = 10); translate([14.95, 28.05]) circle(d = 0.8, $fn = 10); }
    hull() { translate([6.1, 34.2]) circle(d = 0.8, $fn = 10); translate([21.7, 49.8]) circle(d = 0.8, $fn = 10); }
    hull() { translate([3.4, 34.35]) circle(d = 0.8, $fn = 10); translate([3.4, 35.25]) circle(d = 0.8, $fn = 10); }
    hull() { translate([3.4, 35.25]) circle(d = 0.8, $fn = 10); translate([15.7, 47.55]) circle(d = 0.8, $fn = 10); }
    hull() { translate([5.65, 28.35]) circle(d = 0.8, $fn = 10); translate([3.4, 30.6]) circle(d = 0.8, $fn = 10); }
    hull() { translate([5.65, 21.6]) circle(d = 0.8, $fn = 10); translate([5.65, 28.35]) circle(d = 0.8, $fn = 10); }
    hull() { translate([1.3, 36.9]) circle(d = 0.8, $fn = 10); translate([9.7, 45.3]) circle(d = 0.8, $fn = 10); }
    hull() { translate([2.35, 30.6]) circle(d = 0.8, $fn = 10); translate([1.3, 31.65]) circle(d = 0.8, $fn = 10); }
    hull() { translate([3.4, 30.6]) circle(d = 0.8, $fn = 10); translate([2.35, 30.6]) circle(d = 0.8, $fn = 10); }
    hull() { translate([3.25, 19.2]) circle(d = 0.8, $fn = 10); translate([5.65, 21.6]) circle(d = 0.8, $fn = 10); }
    hull() { translate([1.3, 31.65]) circle(d = 0.8, $fn = 10); translate([1.3, 36.9]) circle(d = 0.8, $fn = 10); }
    hull() { translate([31.15, 10.35]) circle(d = 0.8, $fn = 10); translate([36.25, 10.35]) circle(d = 0.8, $fn = 10); }
    hull() { translate([36.25, 10.35]) circle(d = 0.8, $fn = 10); translate([43.45, 17.55]) circle(d = 0.8, $fn = 10); }
    hull() { translate([12.55, 9.45]) circle(d = 0.8, $fn = 10); translate([30.25, 9.45]) circle(d = 0.8, $fn = 10); }
    hull() { translate([5.65, 16.35]) circle(d = 0.8, $fn = 10); translate([12.7, 9.3]) circle(d = 0.8, $fn = 10); }
    hull() { translate([30.25, 9.45]) circle(d = 0.8, $fn = 10); translate([31.75, 10.95]) circle(d = 0.8, $fn = 10); }
    hull() { translate([65.65, 21.3]) circle(d = 0.8, $fn = 10); translate([67.0, 22.65]) circle(d = 0.8, $fn = 10); }
    hull() { translate([15.85, 11.85]) circle(d = 0.8, $fn = 10); translate([23.2, 11.85]) circle(d = 0.8, $fn = 10); }
    hull() { translate([37.0, 3.75]) circle(d = 0.8, $fn = 10); translate([47.95, 3.75]) circle(d = 0.8, $fn = 10); }
    hull() { translate([47.95, 3.75]) circle(d = 0.8, $fn = 10); translate([65.5, 21.3]) circle(d = 0.8, $fn = 10); }
    hull() { translate([65.5, 21.3]) circle(d = 0.8, $fn = 10); translate([65.65, 21.3]) circle(d = 0.8, $fn = 10); }
    hull() { translate([11.2, 16.5]) circle(d = 0.8, $fn = 10); translate([15.85, 11.85]) circle(d = 0.8, $fn = 10); }
    hull() { translate([67.0, 22.65]) circle(d = 0.8, $fn = 10); translate([67.0, 29.55]) circle(d = 0.8, $fn = 10); }
    hull() { translate([33.7, 7.05]) circle(d = 0.8, $fn = 10); translate([37.0, 3.75]) circle(d = 0.8, $fn = 10); }
    hull() { translate([28.0, 11.85]) circle(d = 0.8, $fn = 10); translate([28.45, 12.3]) circle(d = 0.8, $fn = 10); }
    hull() { translate([23.2, 11.85]) circle(d = 0.8, $fn = 10); translate([28.0, 11.85]) circle(d = 0.8, $fn = 10); }
    hull() { translate([42.4, 20.1]) circle(d = 0.8, $fn = 10); translate([50.8, 20.1]) circle(d = 0.8, $fn = 10); }
    hull() { translate([33.25, 20.55]) circle(d = 0.8, $fn = 10); translate([41.95, 20.55]) circle(d = 0.8, $fn = 10); }
    hull() { translate([53.65, 34.95]) circle(d = 0.8, $fn = 10); translate([51.1, 37.5]) circle(d = 0.8, $fn = 10); }
    hull() { translate([41.95, 20.55]) circle(d = 0.8, $fn = 10); translate([42.4, 20.1]) circle(d = 0.8, $fn = 10); }
    hull() { translate([53.65, 22.95]) circle(d = 0.8, $fn = 10); translate([53.65, 34.95]) circle(d = 0.8, $fn = 10); }
    hull() { translate([51.1, 37.5]) circle(d = 0.8, $fn = 10); translate([24.7, 37.5]) circle(d = 0.8, $fn = 10); }
    hull() { translate([31.6, 18.9]) circle(d = 0.8, $fn = 10); translate([33.25, 20.55]) circle(d = 0.8, $fn = 10); }
    hull() { translate([50.8, 20.1]) circle(d = 0.8, $fn = 10); translate([53.65, 22.95]) circle(d = 0.8, $fn = 10); }
    hull() { translate([50.8, 20.1]) circle(d = 0.8, $fn = 10); translate([50.8, 13.65]) circle(d = 0.8, $fn = 10); }
    hull() { translate([50.8, 13.65]) circle(d = 0.8, $fn = 10); translate([52.0, 12.45]) circle(d = 0.8, $fn = 10); }
    hull() { translate([59.95, 29.55]) circle(d = 0.8, $fn = 10); translate([58.75, 29.55]) circle(d = 0.8, $fn = 10); }
    hull() { translate([68.95, 38.55]) circle(d = 0.8, $fn = 10); translate([63.7, 33.3]) circle(d = 0.8, $fn = 10); }
    hull() { translate([73.6, 38.55]) circle(d = 0.8, $fn = 10); translate([68.95, 38.55]) circle(d = 0.8, $fn = 10); }
    hull() { translate([58.75, 29.55]) circle(d = 0.8, $fn = 10); translate([57.7, 30.6]) circle(d = 0.8, $fn = 10); }
    hull() { translate([64.0, 33.6]) circle(d = 0.8, $fn = 10); translate([54.85, 42.75]) circle(d = 0.8, $fn = 10); }
    hull() { translate([72.55, 26.4]) circle(d = 0.8, $fn = 10); translate([76.15, 22.8]) circle(d = 0.8, $fn = 10); }
    hull() { translate([76.15, 6.45]) circle(d = 0.8, $fn = 10); translate([72.85, 6.45]) circle(d = 0.8, $fn = 10); }
    hull() { translate([76.15, 22.8]) circle(d = 0.8, $fn = 10); translate([76.15, 6.45]) circle(d = 0.8, $fn = 10); }
    hull() { translate([70.0, 32.55]) circle(d = 0.8, $fn = 10); translate([70.0, 28.95]) circle(d = 0.8, $fn = 10); }
    hull() { translate([70.0, 28.95]) circle(d = 0.8, $fn = 10); translate([72.55, 26.4]) circle(d = 0.8, $fn = 10); }
    hull() { translate([72.85, 6.45]) circle(d = 0.8, $fn = 10); translate([72.7, 6.3]) circle(d = 0.8, $fn = 10); }
    hull() { translate([70.15, 14.25]) circle(d = 0.8, $fn = 10); translate([63.55, 14.25]) circle(d = 0.8, $fn = 10); }
    hull() { translate([40.45, 39.3]) circle(d = 0.8, $fn = 10); translate([39.7, 40.05]) circle(d = 0.8, $fn = 10); }
    hull() { translate([53.95, 39.3]) circle(d = 0.8, $fn = 10); translate([40.45, 39.3]) circle(d = 0.8, $fn = 10); }
    hull() { translate([64.45, 28.8]) circle(d = 0.8, $fn = 10); translate([53.95, 39.3]) circle(d = 0.8, $fn = 10); }
    hull() { translate([73.45, 17.55]) circle(d = 0.8, $fn = 10); translate([70.15, 14.25]) circle(d = 0.8, $fn = 10); }
    hull() { translate([64.9, 16.8]) circle(d = 0.8, $fn = 10); translate([67.45, 16.8]) circle(d = 0.8, $fn = 10); }
    hull() { translate([78.7, 10.05]) circle(d = 0.8, $fn = 10); translate([80.8, 10.05]) circle(d = 0.8, $fn = 10); }
    hull() { translate([47.2, 7.05]) circle(d = 0.8, $fn = 10); translate([37.45, 7.05]) circle(d = 0.8, $fn = 10); }
    hull() { translate([48.7, 8.55]) circle(d = 0.8, $fn = 10); translate([47.2, 7.05]) circle(d = 0.8, $fn = 10); }
    translate([31.45, 42.3]) circle(d = 2.5, $fn = 16);
    translate([38.6, 33.0]) rotate(-90.0) hull() { translate([0.6, 0]) circle(d = 1.8, $fn = 12); translate([-0.6, 0]) circle(d = 1.8, $fn = 12); }
    translate([36.06, 33.0]) rotate(-90.0) hull() { translate([0.6, 0]) circle(d = 1.8, $fn = 12); translate([-0.6, 0]) circle(d = 1.8, $fn = 12); }
    translate([33.52, 33.0]) rotate(-90.0) hull() { translate([0.6, 0]) circle(d = 1.8, $fn = 12); translate([-0.6, 0]) circle(d = 1.8, $fn = 12); }
    translate([30.98, 33.0]) rotate(-90.0) hull() { translate([0.6, 0]) circle(d = 1.8, $fn = 12); translate([-0.6, 0]) circle(d = 1.8, $fn = 12); }
    translate([28.44, 33.0]) rotate(-90.0) hull() { translate([0.6, 0]) circle(d = 1.8, $fn = 12); translate([-0.6, 0]) circle(d = 1.8, $fn = 12); }
    translate([25.9, 33.0]) rotate(-90.0) hull() { translate([0.6, 0]) circle(d = 1.8, $fn = 12); translate([-0.6, 0]) circle(d = 1.8, $fn = 12); }
    translate([23.36, 33.0]) rotate(-90.0) hull() { translate([0.6, 0]) circle(d = 1.8, $fn = 12); translate([-0.6, 0]) circle(d = 1.8, $fn = 12); }
    translate([20.82, 33.0]) rotate(-90.0) hull() { translate([0.6, 0]) circle(d = 1.8, $fn = 12); translate([-0.6, 0]) circle(d = 1.8, $fn = 12); }
    translate([18.28, 33.0]) rotate(-90.0) hull() { translate([0.6, 0]) circle(d = 1.8, $fn = 12); translate([-0.6, 0]) circle(d = 1.8, $fn = 12); }
    translate([15.74, 33.0]) rotate(-90.0) hull() { translate([0.6, 0]) circle(d = 1.8, $fn = 12); translate([-0.6, 0]) circle(d = 1.8, $fn = 12); }
    translate([13.2, 33.0]) rotate(-90.0) hull() { translate([0.6, 0]) circle(d = 1.8, $fn = 12); translate([-0.6, 0]) circle(d = 1.8, $fn = 12); }
    translate([10.66, 33.0]) rotate(-90.0) hull() { translate([0.6, 0]) circle(d = 1.8, $fn = 12); translate([-0.6, 0]) circle(d = 1.8, $fn = 12); }
    translate([8.12, 33.0]) rotate(-90.0) hull() { translate([0.6, 0]) circle(d = 1.8, $fn = 12); translate([-0.6, 0]) circle(d = 1.8, $fn = 12); }
    translate([5.58, 33.0]) rotate(-90.0) hull() { translate([0.6, 0]) circle(d = 1.8, $fn = 12); translate([-0.6, 0]) circle(d = 1.8, $fn = 12); }
    translate([3.04, 33.0]) rotate(-90.0) hull() { translate([0.6, 0]) circle(d = 1.8, $fn = 12); translate([-0.6, 0]) circle(d = 1.8, $fn = 12); }
    translate([3.04, 17.76]) rotate(-90.0) hull() { translate([0.6, 0]) circle(d = 1.8, $fn = 12); translate([-0.6, 0]) circle(d = 1.8, $fn = 12); }
    translate([5.58, 17.76]) rotate(-90.0) hull() { translate([0.6, 0]) circle(d = 1.8, $fn = 12); translate([-0.6, 0]) circle(d = 1.8, $fn = 12); }
    translate([8.12, 17.76]) rotate(-90.0) hull() { translate([0.6, 0]) circle(d = 1.8, $fn = 12); translate([-0.6, 0]) circle(d = 1.8, $fn = 12); }
    translate([10.66, 17.76]) rotate(-90.0) hull() { translate([0.6, 0]) circle(d = 1.8, $fn = 12); translate([-0.6, 0]) circle(d = 1.8, $fn = 12); }
    translate([13.2, 17.76]) rotate(-90.0) hull() { translate([0.6, 0]) circle(d = 1.8, $fn = 12); translate([-0.6, 0]) circle(d = 1.8, $fn = 12); }
    translate([15.74, 17.76]) rotate(-90.0) hull() { translate([0.6, 0]) circle(d = 1.8, $fn = 12); translate([-0.6, 0]) circle(d = 1.8, $fn = 12); }
    translate([18.28, 17.76]) rotate(-90.0) hull() { translate([0.6, 0]) circle(d = 1.8, $fn = 12); translate([-0.6, 0]) circle(d = 1.8, $fn = 12); }
    translate([20.82, 17.76]) rotate(-90.0) hull() { translate([0.6, 0]) circle(d = 1.8, $fn = 12); translate([-0.6, 0]) circle(d = 1.8, $fn = 12); }
    translate([23.36, 17.76]) rotate(-90.0) hull() { translate([0.6, 0]) circle(d = 1.8, $fn = 12); translate([-0.6, 0]) circle(d = 1.8, $fn = 12); }
    translate([25.9, 17.76]) rotate(-90.0) hull() { translate([0.6, 0]) circle(d = 1.8, $fn = 12); translate([-0.6, 0]) circle(d = 1.8, $fn = 12); }
    translate([28.44, 17.76]) rotate(-90.0) hull() { translate([0.6, 0]) circle(d = 1.8, $fn = 12); translate([-0.6, 0]) circle(d = 1.8, $fn = 12); }
    translate([30.98, 17.76]) rotate(-90.0) hull() { translate([0.6, 0]) circle(d = 1.8, $fn = 12); translate([-0.6, 0]) circle(d = 1.8, $fn = 12); }
    translate([33.52, 17.76]) rotate(-90.0) hull() { translate([0.6, 0]) circle(d = 1.8, $fn = 12); translate([-0.6, 0]) circle(d = 1.8, $fn = 12); }
    translate([36.06, 17.76]) rotate(-90.0) hull() { translate([0.6, 0]) circle(d = 1.8, $fn = 12); translate([-0.6, 0]) circle(d = 1.8, $fn = 12); }
    translate([38.6, 17.76]) rotate(-90.0) hull() { translate([0.6, 0]) circle(d = 1.8, $fn = 12); translate([-0.6, 0]) circle(d = 1.8, $fn = 12); }
    translate([2.775, 26.0]) circle(d = 0.8, $fn = 16);
    translate([23.75, 38.25]) circle(d = 2.5, $fn = 16);
    translate([23.75, 43.25]) circle(d = 2.5, $fn = 16);
    translate([74.75, 39.0]) circle(d = 2.5, $fn = 16);
    translate([69.362, 33.612]) circle(d = 2.5, $fn = 16);
    translate([62.25, 14.75]) rotate(45.0) hull() { translate([0, 0.6]) circle(d = 1.8, $fn = 12); translate([0, -0.6]) circle(d = 1.8, $fn = 12); }
    translate([64.018, 16.518]) rotate(45.0) hull() { translate([0, 0.6]) circle(d = 1.8, $fn = 12); translate([0, -0.6]) circle(d = 1.8, $fn = 12); }
    translate([19.45, 14.55]) circle(d = 2.5, $fn = 16);
    translate([33.0, 10.75]) rotate(45.0) hull() { translate([0, 0.6]) circle(d = 1.8, $fn = 12); translate([0, -0.6]) circle(d = 1.8, $fn = 12); }
    translate([34.768, 12.518]) rotate(45.0) hull() { translate([0, 0.6]) circle(d = 1.8, $fn = 12); translate([0, -0.6]) circle(d = 1.8, $fn = 12); }
    translate([73.0, 25.25]) circle(d = 2.5, $fn = 16);
    translate([67.612, 30.638]) circle(d = 2.5, $fn = 16);
    translate([65.95, 2.55]) circle(d = 2.5, $fn = 16);
    translate([54.25, 36.0]) circle(d = 2.5, $fn = 16);
    translate([54.25, 43.62]) circle(d = 2.5, $fn = 16);
    translate([56.25, 30.75]) rotate(-90.0) hull() { translate([0, 0.6]) circle(d = 1.8, $fn = 12); translate([0, -0.6]) circle(d = 1.8, $fn = 12); }
    translate([56.25, 28.25]) rotate(-90.0) hull() { translate([0, 0.6]) circle(d = 1.8, $fn = 12); translate([0, -0.6]) circle(d = 1.8, $fn = 12); }
    translate([81.725, 26.0]) circle(d = 0.8, $fn = 16);
    translate([50.2, 25.8]) circle(d = 2.5, $fn = 16);
    translate([30.7, 3.3]) circle(d = 2.5, $fn = 16);
    translate([24.5, 12.25]) rotate(135.0) hull() { translate([0, 0.6]) circle(d = 1.8, $fn = 12); translate([0, -0.6]) circle(d = 1.8, $fn = 12); }
    translate([22.732, 14.018]) rotate(135.0) hull() { translate([0, 0.6]) circle(d = 1.8, $fn = 12); translate([0, -0.6]) circle(d = 1.8, $fn = 12); }
    translate([52.25, 11.25]) circle(d = 2.5, $fn = 16);
    translate([46.862, 5.862]) circle(d = 2.5, $fn = 16);
    translate([56.2, 25.05]) circle(d = 2.5, $fn = 16);
    translate([76.5, 5.25]) circle(d = 2.5, $fn = 16);
    translate([81.888, 10.638]) circle(d = 2.5, $fn = 16);
    translate([42.7, 28.05]) circle(d = 2.5, $fn = 16);
    translate([52.0, 20.5]) rotate(135.0) hull() { translate([0, 0.6]) circle(d = 1.8, $fn = 12); translate([0, -0.6]) circle(d = 1.8, $fn = 12); }
    translate([50.232, 22.268]) rotate(135.0) hull() { translate([0, 0.6]) circle(d = 1.8, $fn = 12); translate([0, -0.6]) circle(d = 1.8, $fn = 12); }
    translate([32.5, 24.0]) circle(d = 2.5, $fn = 16);
    translate([39.0, 24.0]) circle(d = 2.5, $fn = 16);
    translate([32.5, 28.5]) circle(d = 2.5, $fn = 16);
    translate([39.0, 28.5]) circle(d = 2.5, $fn = 16);
    translate([71.0, 22.25]) circle(d = 2.5, $fn = 16);
    translate([78.62, 22.25]) circle(d = 2.5, $fn = 16);
    translate([71.75, 2.0]) rotate(135.0) hull() { translate([0, 0.6]) circle(d = 1.8, $fn = 12); translate([0, -0.6]) circle(d = 1.8, $fn = 12); }
    translate([69.954, 3.796]) rotate(135.0) hull() { translate([0, 0.6]) circle(d = 1.8, $fn = 12); translate([0, -0.6]) circle(d = 1.8, $fn = 12); }
    translate([68.158, 5.592]) rotate(135.0) hull() { translate([0, 0.6]) circle(d = 1.8, $fn = 12); translate([0, -0.6]) circle(d = 1.8, $fn = 12); }
    translate([27.25, 28.0]) circle(d = 2.5, $fn = 16);
    translate([21.862, 22.612]) circle(d = 2.5, $fn = 16);
    translate([44.7, 9.35]) rotate(90.0) hull() { translate([0, 0.6]) circle(d = 1.8, $fn = 12); translate([0, -0.6]) circle(d = 1.8, $fn = 12); }
    translate([44.7, 11.89]) rotate(90.0) hull() { translate([0, 0.6]) circle(d = 1.8, $fn = 12); translate([0, -0.6]) circle(d = 1.8, $fn = 12); }
    translate([44.7, 14.43]) rotate(90.0) hull() { translate([0, 0.6]) circle(d = 1.8, $fn = 12); translate([0, -0.6]) circle(d = 1.8, $fn = 12); }
    translate([44.7, 22.61]) rotate(90.0) hull() { translate([0, 0.6]) circle(d = 1.8, $fn = 12); translate([0, -0.6]) circle(d = 1.8, $fn = 12); }
    translate([44.7, 25.15]) rotate(90.0) hull() { translate([0, 0.6]) circle(d = 1.8, $fn = 12); translate([0, -0.6]) circle(d = 1.8, $fn = 12); }
    translate([63.8, 9.35]) rotate(90.0) hull() { translate([0, 0.6]) circle(d = 1.8, $fn = 12); translate([0, -0.6]) circle(d = 1.8, $fn = 12); }
    translate([63.8, 11.89]) rotate(90.0) hull() { translate([0, 0.6]) circle(d = 1.8, $fn = 12); translate([0, -0.6]) circle(d = 1.8, $fn = 12); }
    translate([63.8, 22.61]) rotate(90.0) hull() { translate([0, 0.6]) circle(d = 1.8, $fn = 12); translate([0, -0.6]) circle(d = 1.8, $fn = 12); }
    translate([63.8, 25.15]) rotate(90.0) hull() { translate([0, 0.6]) circle(d = 1.8, $fn = 12); translate([0, -0.6]) circle(d = 1.8, $fn = 12); }
    translate([17.25, 21.5]) rotate(45.0) hull() { translate([0.6, 0]) circle(d = 1.8, $fn = 12); translate([-0.6, 0]) circle(d = 1.8, $fn = 12); }
    translate([15.454, 23.296]) rotate(45.0) hull() { translate([0.6, 0]) circle(d = 1.8, $fn = 12); translate([-0.6, 0]) circle(d = 1.8, $fn = 12); }
    translate([13.658, 25.092]) rotate(45.0) hull() { translate([0.6, 0]) circle(d = 1.8, $fn = 12); translate([-0.6, 0]) circle(d = 1.8, $fn = 12); }
    translate([13.0, 4.0]) rotate(180.0) hull() { translate([0, 0.6]) circle(d = 1.8, $fn = 12); translate([0, -0.6]) circle(d = 1.8, $fn = 12); }
    translate([10.5, 4.0]) rotate(180.0) hull() { translate([0, 0.6]) circle(d = 1.8, $fn = 12); translate([0, -0.6]) circle(d = 1.8, $fn = 12); }
    translate([42.75, 41.25]) circle(d = 2.0, $fn = 16);
    translate([45.29, 41.25]) circle(d = 2.0, $fn = 16);
    translate([42.75, 43.79]) circle(d = 2.0, $fn = 16);
    translate([45.29, 43.79]) circle(d = 2.0, $fn = 16);
    translate([42.75, 46.33]) circle(d = 2.0, $fn = 16);
    translate([45.29, 46.33]) circle(d = 2.0, $fn = 16);
    translate([42.75, 48.87]) circle(d = 2.0, $fn = 16);
    translate([45.29, 48.87]) circle(d = 2.0, $fn = 16);
    translate([27.0, 7.25]) rotate(-45.0) hull() { translate([0, 0.6]) circle(d = 1.8, $fn = 12); translate([0, -0.6]) circle(d = 1.8, $fn = 12); }
    translate([28.768, 5.482]) rotate(-45.0) hull() { translate([0, 0.6]) circle(d = 1.8, $fn = 12); translate([0, -0.6]) circle(d = 1.8, $fn = 12); }
    translate([36.0, 41.5]) rotate(135.0) hull() { translate([0.6, 0]) circle(d = 1.8, $fn = 12); translate([-0.6, 0]) circle(d = 1.8, $fn = 12); }
    translate([34.204, 39.704]) rotate(135.0) hull() { translate([0.6, 0]) circle(d = 1.8, $fn = 12); translate([-0.6, 0]) circle(d = 1.8, $fn = 12); }
    translate([62.25, 3.0]) rotate(45.0) hull() { translate([0.6, 0]) circle(d = 1.8, $fn = 12); translate([-0.6, 0]) circle(d = 1.8, $fn = 12); }
    translate([60.454, 4.796]) rotate(45.0) hull() { translate([0.6, 0]) circle(d = 1.8, $fn = 12); translate([-0.6, 0]) circle(d = 1.8, $fn = 12); }
    translate([29.2, 25.05]) circle(d = 2.5, $fn = 12);
    translate([39.7, 43.8]) circle(d = 2.5, $fn = 12);
    translate([48.7, 46.8]) circle(d = 2.5, $fn = 12);
    translate([23.95, 28.05]) circle(d = 2.5, $fn = 12);
    translate([21.7, 49.8]) circle(d = 2.5, $fn = 12);
    translate([15.7, 47.55]) circle(d = 2.5, $fn = 12);
    translate([9.7, 45.3]) circle(d = 2.5, $fn = 12);
    translate([43.45, 17.55]) circle(d = 2.5, $fn = 12);
    translate([12.7, 9.3]) circle(d = 2.5, $fn = 12);
    translate([33.7, 7.05]) circle(d = 2.5, $fn = 12);
    translate([28.45, 12.3]) circle(d = 2.5, $fn = 12);
    translate([41.95, 20.55]) circle(d = 2.5, $fn = 12);
    translate([59.95, 29.55]) circle(d = 2.5, $fn = 12);
    translate([63.7, 33.3]) circle(d = 2.5, $fn = 12);
    translate([72.7, 6.3]) circle(d = 2.5, $fn = 12);
    translate([73.45, 17.55]) circle(d = 2.5, $fn = 12);
    translate([64.45, 28.8]) circle(d = 2.5, $fn = 12);
    translate([39.7, 40.05]) circle(d = 2.5, $fn = 12);
    translate([78.7, 10.05]) circle(d = 2.5, $fn = 12);
    translate([67.45, 16.8]) circle(d = 2.5, $fn = 12);
    translate([37.45, 7.05]) circle(d = 2.5, $fn = 12);
    translate([48.7, 8.55]) circle(d = 2.5, $fn = 12);
  }
  translate([0, 0, 1.6]) { color("#111") { translate([37.33, 31.73, 0]) cube([2.54, 2.54, 8.5]); translate([34.79, 31.73, 0]) cube([2.54, 2.54, 8.5]); translate([32.25, 31.73, 0]) cube([2.54, 2.54, 8.5]); translate([29.71, 31.73, 0]) cube([2.54, 2.54, 8.5]); translate([27.17, 31.73, 0]) cube([2.54, 2.54, 8.5]); translate([24.63, 31.73, 0]) cube([2.54, 2.54, 8.5]); translate([22.09, 31.73, 0]) cube([2.54, 2.54, 8.5]); translate([19.55, 31.73, 0]) cube([2.54, 2.54, 8.5]); translate([17.01, 31.73, 0]) cube([2.54, 2.54, 8.5]); translate([14.47, 31.73, 0]) cube([2.54, 2.54, 8.5]); translate([11.93, 31.73, 0]) cube([2.54, 2.54, 8.5]); translate([9.39, 31.73, 0]) cube([2.54, 2.54, 8.5]); translate([6.85, 31.73, 0]) cube([2.54, 2.54, 8.5]); translate([4.3100000000000005, 31.73, 0]) cube([2.54, 2.54, 8.5]); translate([1.77, 31.73, 0]) cube([2.54, 2.54, 8.5]); translate([1.77, 16.490000000000002, 0]) cube([2.54, 2.54, 8.5]); translate([4.3100000000000005, 16.490000000000002, 0]) cube([2.54, 2.54, 8.5]); translate([6.85, 16.490000000000002, 0]) cube([2.54, 2.54, 8.5]); translate([9.39, 16.490000000000002, 0]) cube([2.54, 2.54, 8.5]); translate([11.93, 16.490000000000002, 0]) cube([2.54, 2.54, 8.5]); translate([14.47, 16.490000000000002, 0]) cube([2.54, 2.54, 8.5]); translate([17.01, 16.490000000000002, 0]) cube([2.54, 2.54, 8.5]); translate([19.55, 16.490000000000002, 0]) cube([2.54, 2.54, 8.5]); translate([22.09, 16.490000000000002, 0]) cube([2.54, 2.54, 8.5]); translate([24.63, 16.490000000000002, 0]) cube([2.54, 2.54, 8.5]); translate([27.17, 16.490000000000002, 0]) cube([2.54, 2.54, 8.5]); translate([29.71, 16.490000000000002, 0]) cube([2.54, 2.54, 8.5]); translate([32.25, 16.490000000000002, 0]) cube([2.54, 2.54, 8.5]); translate([34.79, 16.490000000000002, 0]) cube([2.54, 2.54, 8.5]); translate([37.33, 16.490000000000002, 0]) cube([2.54, 2.54, 8.5]); } color("#1d4fa8") translate([-1.1600000000000001, 16.16, 8.5]) cube([41.96000000000001, 18.439999999999998, 1.6]); color("silver") translate([-2.66, 21.480000000000004, 10.1]) cube([9, 7.8, 4]); color("#111") translate([16.32, 21.880000000000003, 10.1]) rotate(45) cube([7, 7, 1.2], center = false); color("#ddd") translate([27.82, 23.880000000000003, 10.1]) cube([3, 3, 1.5]); }
  translate([0, 0, 1.6]) translate([23.75, 40.75, 0.5]) { color("#1b2a5c") cylinder(d = 10.0, h = 16, $fn = 40); color("#b0b6c8") translate([0, 0, 16]) cylinder(d = 9.4, h = 0.2, $fn = 40); }
  translate([0, 0, 1.6]) translate([72.056, 36.306, 0]) rotate(-135.00000000000006) { color("#d8c08a") translate([-3.15, 0, 1.6]) rotate([0, 90, 0]) cylinder(d = 2.5, h = 6.3, $fn = 20); color("silver") for (s = [-1, 1]) { translate([s * 3.809891337033119, 0, 0]) cylinder(d = 0.6, h = 1.6, $fn = 8); } color("silver") translate([-3.809891337033119, 0, 1.6]) rotate([0, 90, 0]) cylinder(d = 0.6, h = 7.619782674066238, $fn = 8); }
  translate([0, 0, 1.6]) translate([63.134, 15.634, 1.5]) rotate(45.0) color("#d9a531") translate([0, 1.25, 2.5]) rotate([90, 0, 0]) cylinder(d = 5, h = 2.5, $fn = 30);
  translate([0, 0, 1.6]) translate([33.884, 11.634, 1.5]) rotate(45.0) color("#d9a531") translate([0, 1.25, 2.5]) rotate([90, 0, 0]) cylinder(d = 5, h = 2.5, $fn = 30);
  translate([0, 0, 1.6]) translate([70.306, 27.944000000000003, 0]) rotate(135.00000000000003) { color("#d8c08a") translate([-3.15, 0, 1.6]) rotate([0, 90, 0]) cylinder(d = 2.5, h = 6.3, $fn = 20); color("silver") for (s = [-1, 1]) { translate([s * 3.8098913370331204, 0, 0]) cylinder(d = 0.6, h = 1.6, $fn = 8); } color("silver") translate([-3.8098913370331204, 0, 1.6]) rotate([0, 90, 0]) cylinder(d = 0.6, h = 7.619782674066241, $fn = 8); }
  translate([0, 0, 1.6]) translate([54.25, 39.81, 0]) rotate(90.0) { color("#d8c08a") translate([-3.15, 0, 1.6]) rotate([0, 90, 0]) cylinder(d = 2.5, h = 6.3, $fn = 20); color("silver") for (s = [-1, 1]) { translate([s * 3.8099999999999987, 0, 0]) cylinder(d = 0.6, h = 1.6, $fn = 8); } color("silver") translate([-3.8099999999999987, 0, 1.6]) rotate([0, 90, 0]) cylinder(d = 0.6, h = 7.619999999999997, $fn = 8); }
  translate([0, 0, 1.6]) translate([56.25, 29.5, 0.5]) { color("#1b2a5c") cylinder(d = 6.3, h = 11, $fn = 40); color("#b0b6c8") translate([0, 0, 11]) cylinder(d = 5.7, h = 0.2, $fn = 40); }
  translate([0, 0, 1.6]) translate([23.616, 13.134, 1.5]) rotate(135.0) color("#d9a531") translate([0, 1.25, 2.5]) rotate([90, 0, 0]) cylinder(d = 5, h = 2.5, $fn = 30);
  translate([0, 0, 1.6]) translate([49.556, 8.556000000000001, 0]) rotate(-135.0) { color("#d8c08a") translate([-3.15, 0, 1.6]) rotate([0, 90, 0]) cylinder(d = 2.5, h = 6.3, $fn = 20); color("silver") for (s = [-1, 1]) { translate([s * 3.8098913370331173, 0, 0]) cylinder(d = 0.6, h = 1.6, $fn = 8); } color("silver") translate([-3.8098913370331173, 0, 1.6]) rotate([0, 90, 0]) cylinder(d = 0.6, h = 7.619782674066235, $fn = 8); }
  translate([0, 0, 1.6]) translate([79.194, 7.944, 0]) rotate(44.99999999999997) { color("#d8c08a") translate([-3.15, 0, 1.6]) rotate([0, 90, 0]) cylinder(d = 2.5, h = 6.3, $fn = 20); color("silver") for (s = [-1, 1]) { translate([s * 3.80989133703312, 0, 0]) cylinder(d = 0.6, h = 1.6, $fn = 8); } color("silver") translate([-3.80989133703312, 0, 1.6]) rotate([0, 90, 0]) cylinder(d = 0.6, h = 7.61978267406624, $fn = 8); }
  translate([0, 0, 1.6]) translate([51.116, 21.384, 1.5]) rotate(135.0) color("#d9a531") translate([0, 1.25, 2.5]) rotate([90, 0, 0]) cylinder(d = 5, h = 2.5, $fn = 30);
  mirror([0, 0, 1]) translate([39.0, 26.25, 0]) { color("#2a2a2a") translate([-3, -3, 0]) cube([6, 6, 3.5]); color("#444") cylinder(d = 3.5, h = 5, $fn = 24); }
  mirror([0, 0, 1]) translate([74.81, 22.25, 0]) rotate(0.0) { color("#d8c08a") translate([-3.15, 0, 1.6]) rotate([0, 90, 0]) cylinder(d = 2.5, h = 6.3, $fn = 20); color("silver") for (s = [-1, 1]) { translate([s * 3.8100000000000023, 0, 0]) cylinder(d = 0.6, h = 1.6, $fn = 8); } color("silver") translate([-3.8100000000000023, 0, 1.6]) rotate([0, 90, 0]) cylinder(d = 0.6, h = 7.6200000000000045, $fn = 8); }
  mirror([0, 0, 1]) translate([69.95400000000001, 3.796, 2]) rotate(135.0) color("#222") intersection() { cylinder(d = 4.8, h = 4.5, $fn = 30); translate([-3, -1.2, 0]) cube([6, 4, 5]); }
  mirror([0, 0, 1]) translate([24.555999999999997, 25.305999999999997, 0]) rotate(-135.0) { color("#d8c08a") translate([-3.15, 0, 1.6]) rotate([0, 90, 0]) cylinder(d = 2.5, h = 6.3, $fn = 20); color("silver") for (s = [-1, 1]) { translate([s * 3.809891337033119, 0, 0]) cylinder(d = 0.6, h = 1.6, $fn = 8); } color("silver") translate([-3.809891337033119, 0, 1.6]) rotate([0, 90, 0]) cylinder(d = 0.6, h = 7.619782674066238, $fn = 8); }
  mirror([0, 0, 1]) { color("gold") { translate([44.38, 9.03, 0]) cube([0.64, 0.64, 4]); translate([44.38, 11.57, 0]) cube([0.64, 0.64, 4]); translate([44.38, 14.11, 0]) cube([0.64, 0.64, 4]); translate([44.38, 22.29, 0]) cube([0.64, 0.64, 4]); translate([44.38, 24.83, 0]) cube([0.64, 0.64, 4]); translate([63.48, 9.03, 0]) cube([0.64, 0.64, 4]); translate([63.48, 11.57, 0]) cube([0.64, 0.64, 4]); translate([63.48, 22.29, 0]) cube([0.64, 0.64, 4]); translate([63.48, 24.83, 0]) cube([0.64, 0.64, 4]); } color("#2e7d32") translate([43.5, 8.15, 4]) cube([21.499999999999993, 18.2, 1.2]); color("#111") translate([51.75, 15.25, 5.2]) cube([5, 4, 1.2]); color("#dedede") translate([50.25, 20.25, 5.2]) cylinder(d = 6, h = 3, $fn = 24); }
  mirror([0, 0, 1]) translate([17.25, 21.5, 0]) { color("#222") translate([-1.27, -1.27, 0]) cube([2.54, 2.54, 2.5]); color("gold") translate([-0.32, -0.32, 0]) cube([0.64, 0.64, 8.5]); }
  mirror([0, 0, 1]) translate([15.454, 23.296, 0]) { color("#222") translate([-1.27, -1.27, 0]) cube([2.54, 2.54, 2.5]); color("gold") translate([-0.32, -0.32, 0]) cube([0.64, 0.64, 8.5]); }
  mirror([0, 0, 1]) translate([13.658, 25.092, 0]) { color("#222") translate([-1.27, -1.27, 0]) cube([2.54, 2.54, 2.5]); color("gold") translate([-0.32, -0.32, 0]) cube([0.64, 0.64, 8.5]); }
  mirror([0, 0, 1]) translate([11.75, 4.0, 0.5]) { color("#1b2a5c") cylinder(d = 6.3, h = 11, $fn = 40); color("#b0b6c8") translate([0, 0, 11]) cylinder(d = 5.7, h = 0.2, $fn = 40); }
  mirror([0, 0, 1]) { color("#111") { translate([41.48, 39.98, 0]) cube([2.54, 2.54, RADIO_MODULE_HEIGHT]); translate([44.019999999999996, 39.98, 0]) cube([2.54, 2.54, RADIO_MODULE_HEIGHT]); translate([41.48, 42.519999999999996, 0]) cube([2.54, 2.54, RADIO_MODULE_HEIGHT]); translate([44.019999999999996, 42.519999999999996, 0]) cube([2.54, 2.54, RADIO_MODULE_HEIGHT]); translate([41.48, 45.059999999999995, 0]) cube([2.54, 2.54, RADIO_MODULE_HEIGHT]); translate([44.019999999999996, 45.059999999999995, 0]) cube([2.54, 2.54, RADIO_MODULE_HEIGHT]); translate([41.48, 47.599999999999994, 0]) cube([2.54, 2.54, RADIO_MODULE_HEIGHT]); translate([44.019999999999996, 47.599999999999994, 0]) cube([2.54, 2.54, RADIO_MODULE_HEIGHT]); } color("#1a1a1a") translate([41.15, 37.435, RADIO_MODULE_HEIGHT]) cube([40.99999999999999, 15.25, 1.6]); color("#bbb") translate([48.75, 40.06, RADIO_MODULE_HEIGHT+1.6]) cube([14, 10, 2.5]); color("gold") translate([82.14999999999999, 45.06, RADIO_MODULE_HEIGHT+0.8]) rotate([0, 90, 0]) cylinder(d = 6.0, h = 8, $fn = 24); }
  mirror([0, 0, 1]) translate([27.884, 6.366, 0.5]) { color("#1b2a5c") cylinder(d = 6.3, h = 11, $fn = 40); color("#b0b6c8") translate([0, 0, 11]) cylinder(d = 5.7, h = 0.2, $fn = 40); }
  mirror([0, 0, 1]) translate([36.0, 41.5, 0]) { color("#222") translate([-1.27, -1.27, 0]) cube([2.54, 2.54, 2.5]); color("gold") translate([-0.32, -0.32, 0]) cube([0.64, 0.64, 8.5]); }
  mirror([0, 0, 1]) translate([34.204, 39.704, 0]) { color("#222") translate([-1.27, -1.27, 0]) cube([2.54, 2.54, 2.5]); color("gold") translate([-0.32, -0.32, 0]) cube([0.64, 0.64, 8.5]); }
  mirror([0, 0, 1]) translate([62.25, 3.0, 0]) { color("#222") translate([-1.27, -1.27, 0]) cube([2.54, 2.54, 2.5]); color("gold") translate([-0.32, -0.32, 0]) cube([0.64, 0.64, 8.5]); }
  mirror([0, 0, 1]) translate([60.454, 4.796, 0]) { color("#222") translate([-1.27, -1.27, 0]) cube([2.54, 2.54, 2.5]); color("gold") translate([-0.32, -0.32, 0]) cube([0.64, 0.64, 8.5]); }
}
