aluisioalves123/rf-intercom/hardware/fabrication/assembly/01-vias.png

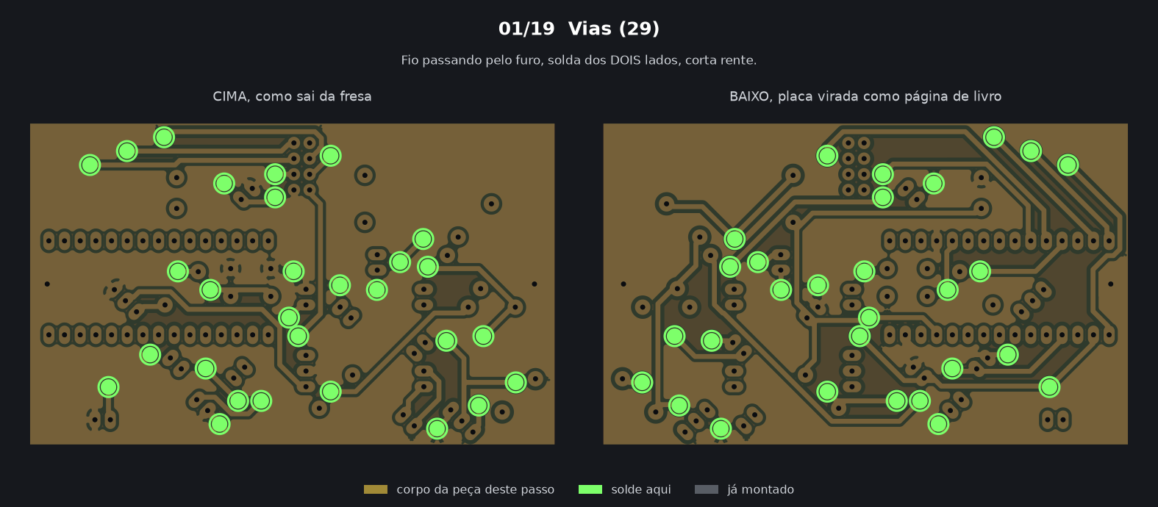
hardware/fabrication/assembly/01-vias.png
