aluisioalves123/rf-intercom/hardware/fabrication/assembly/01a-nets-top.png

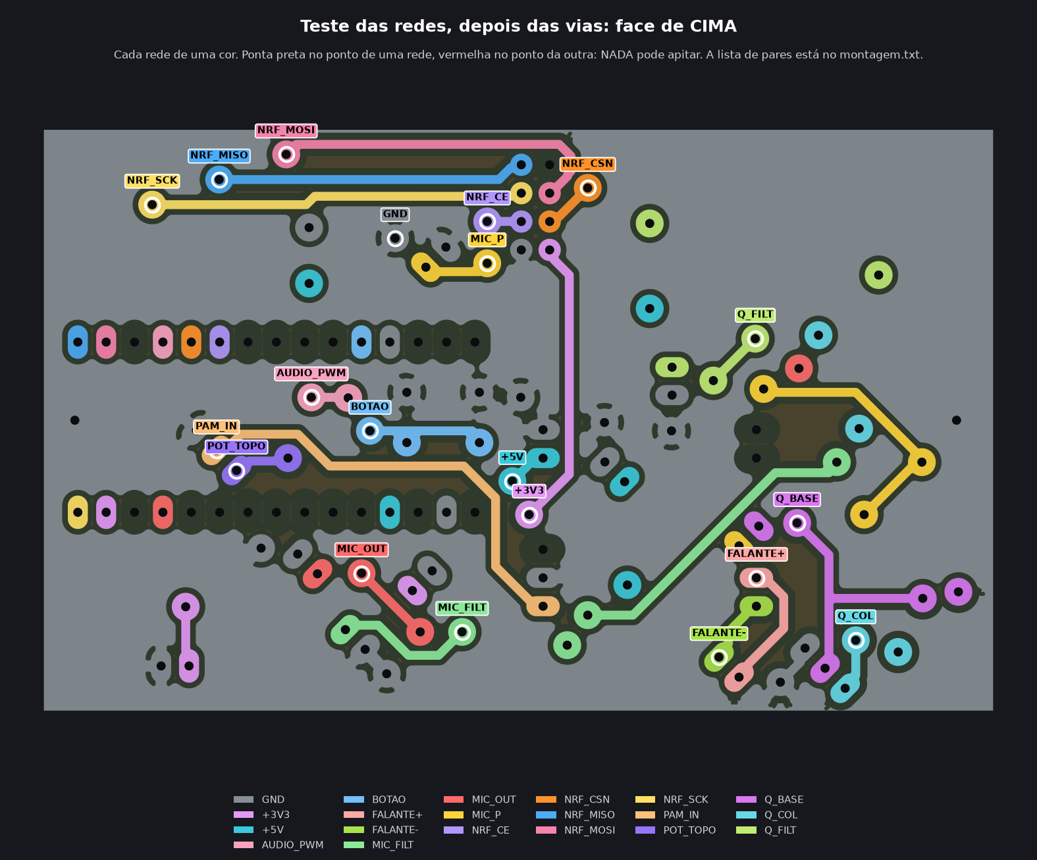
hardware/fabrication/assembly/01a-nets-top.png
