aluisioalves123/rf-intercom/hardware/fabrication/assembly/01b-nets-bottom.png

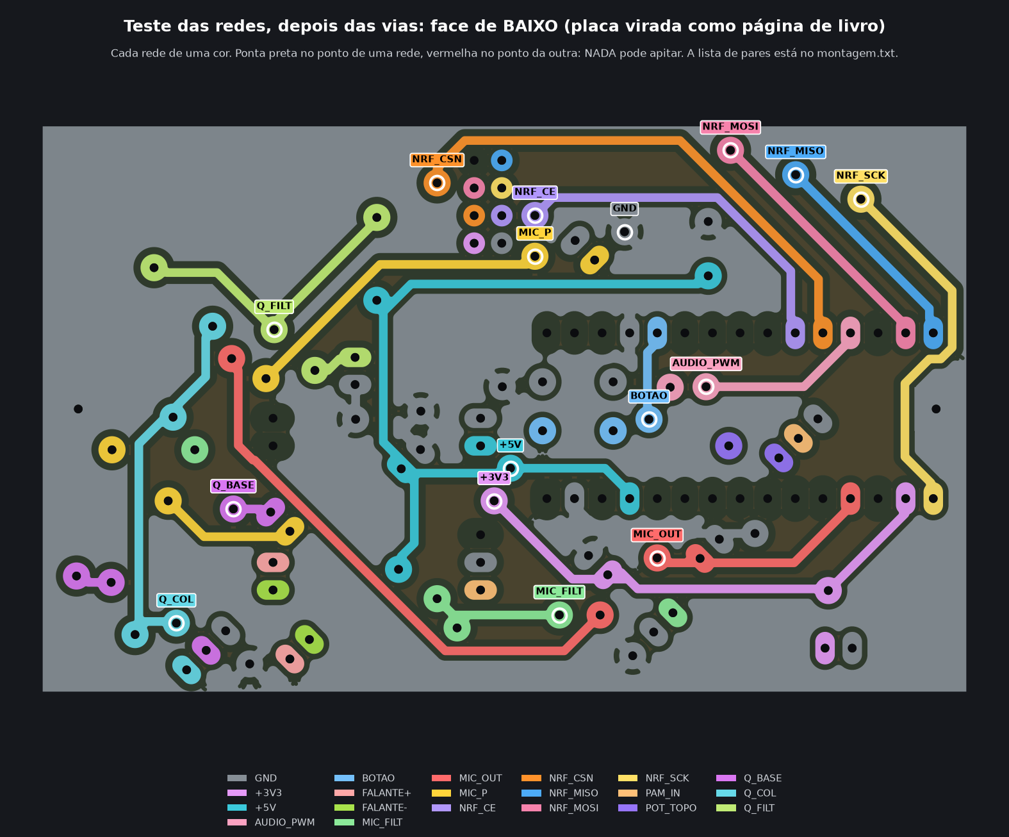
hardware/fabrication/assembly/01b-nets-bottom.png
