aluisioalves123/rf-intercom/hardware/fabrication/assembly/02-C3.png

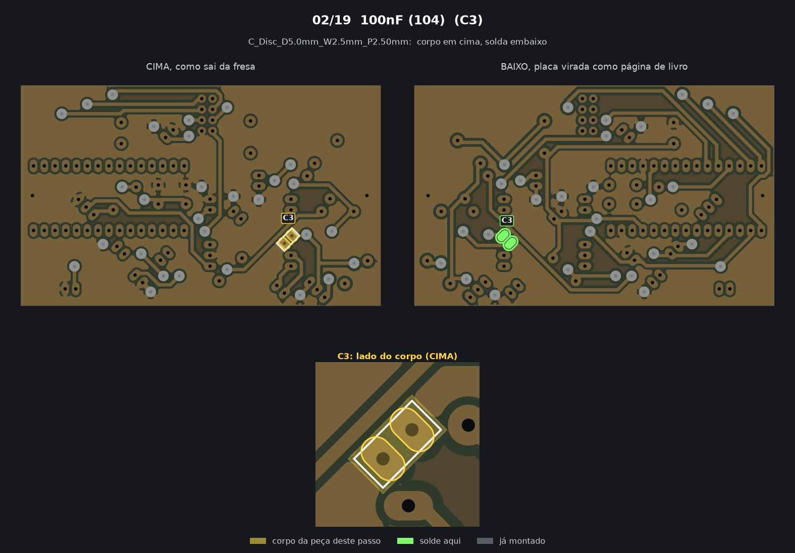
hardware/fabrication/assembly/02-C3.png
