aluisioalves123/rf-intercom/hardware/fabrication/assembly/04-C6-C8.png

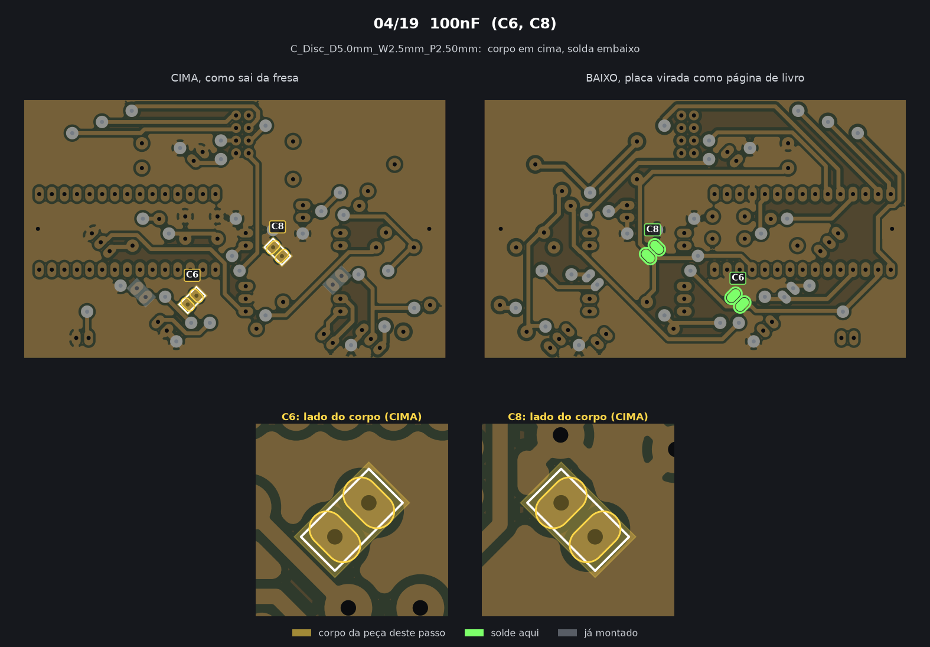
hardware/fabrication/assembly/04-C6-C8.png
