aluisioalves123/rf-intercom/hardware/fabrication/assembly/05-J3.png

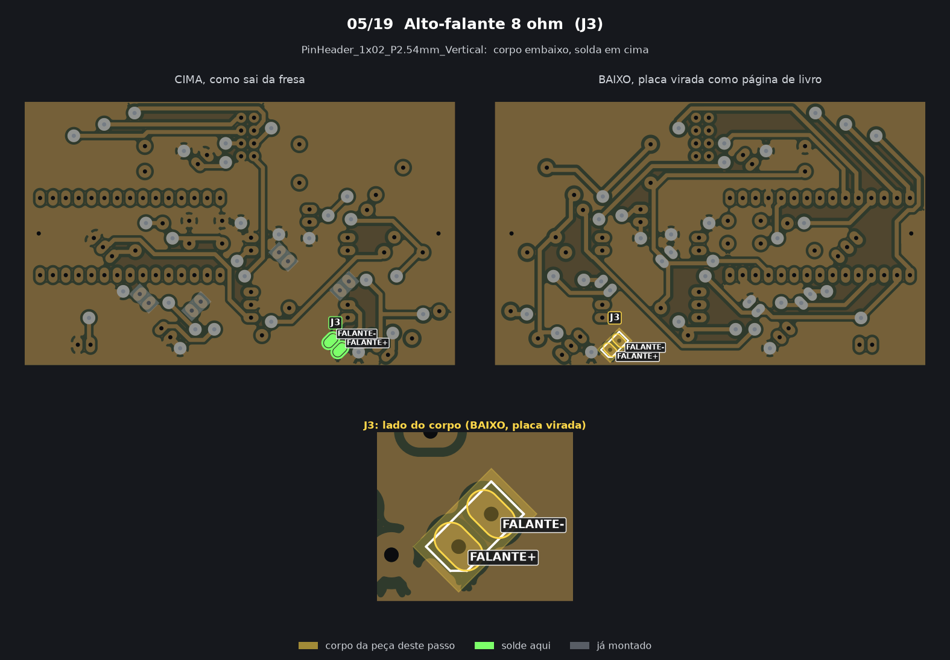
hardware/fabrication/assembly/05-J3.png
