aluisioalves123/rf-intercom/hardware/fabrication/assembly/07-R1.png

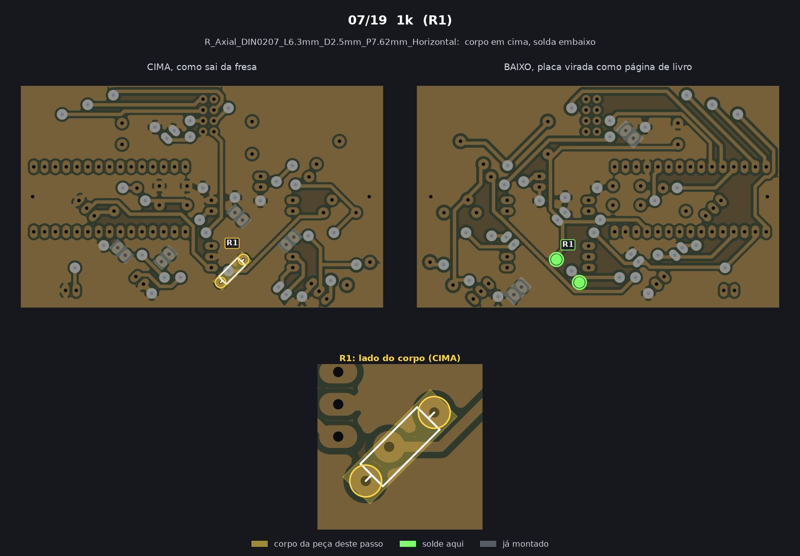
hardware/fabrication/assembly/07-R1.png
