aluisioalves123/rf-intercom/hardware/fabrication/assembly/08-R2-R4-R6.png

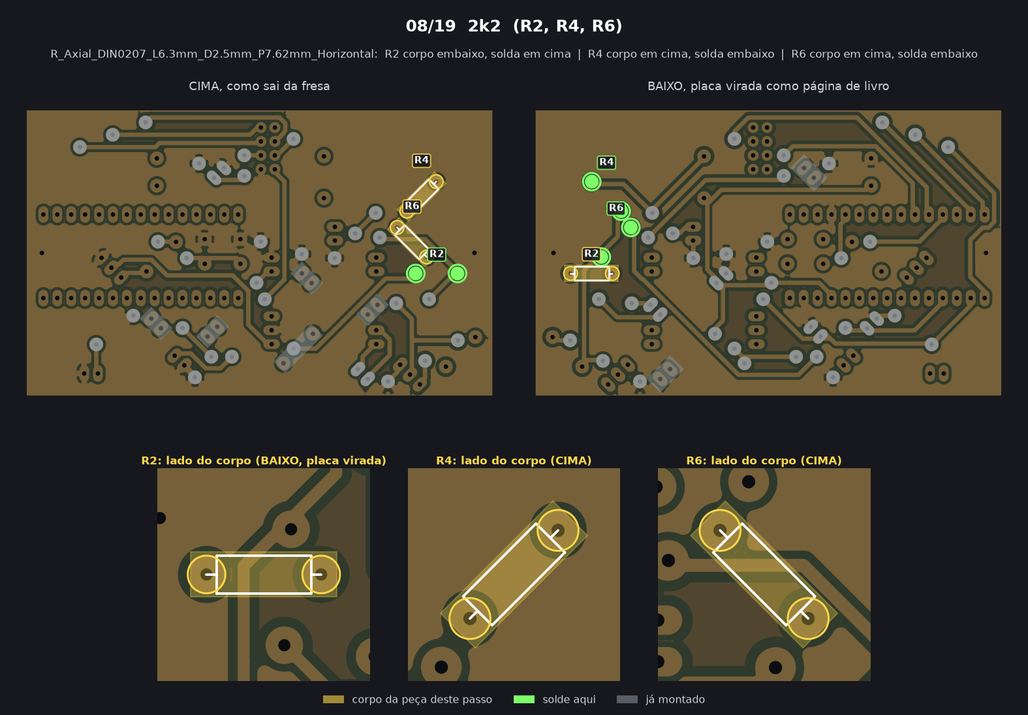
hardware/fabrication/assembly/08-R2-R4-R6.png
