aluisioalves123/rf-intercom/hardware/fabrication/assembly/10-R5.png

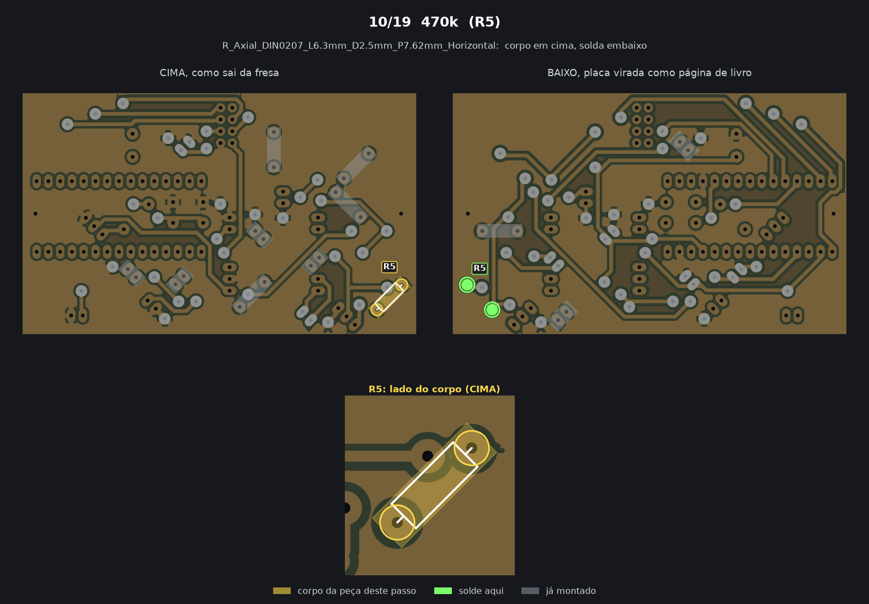
hardware/fabrication/assembly/10-R5.png
