aluisioalves123/rf-intercom/hardware/fabrication/assembly/16-C7.png

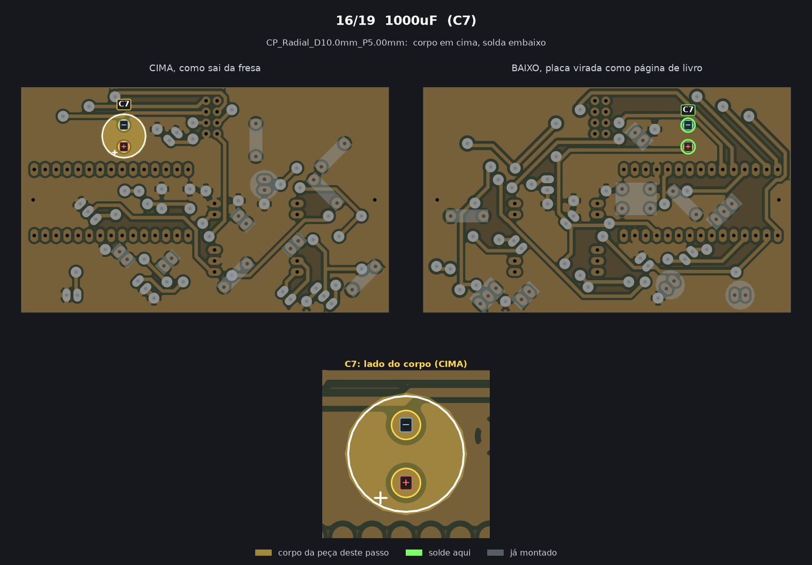
hardware/fabrication/assembly/16-C7.png
