aluisioalves123/rf-intercom/hardware/fabrication/assembly/17-U1.png

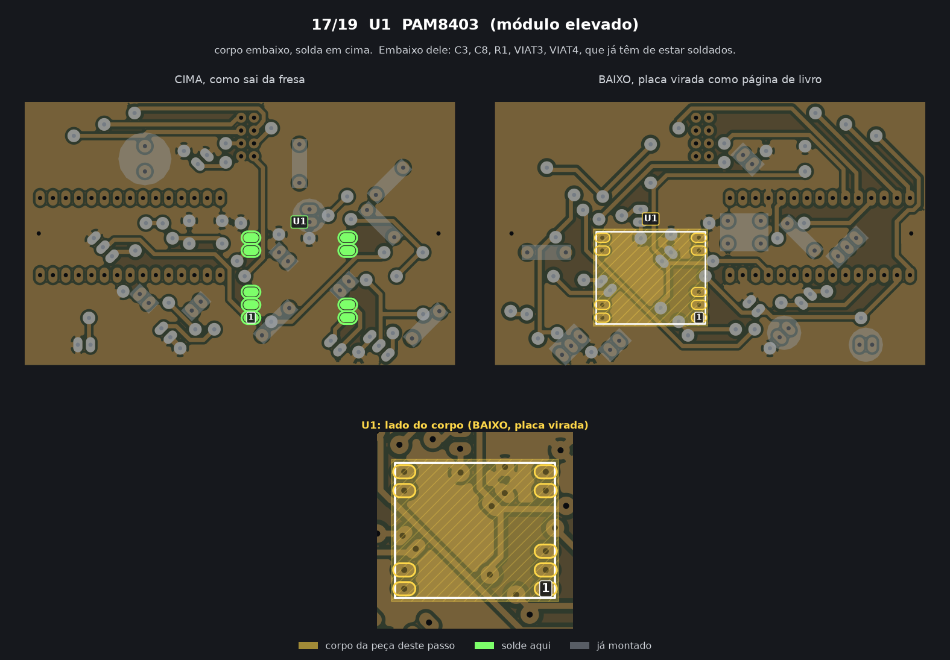
hardware/fabrication/assembly/17-U1.png
