aluisioalves123/rf-intercom/hardware/fabrication/assembly/19-A1.png

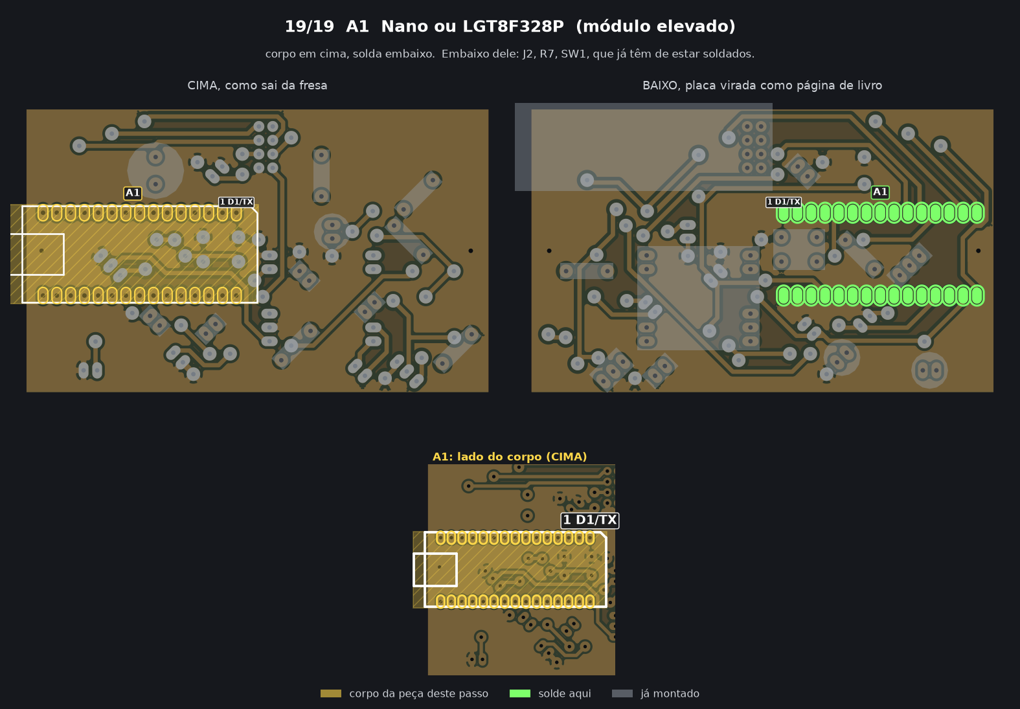
hardware/fabrication/assembly/19-A1.png
