aluisioalves123/rf-intercom/hardware/fabrication/gcode/preview-bottom.png

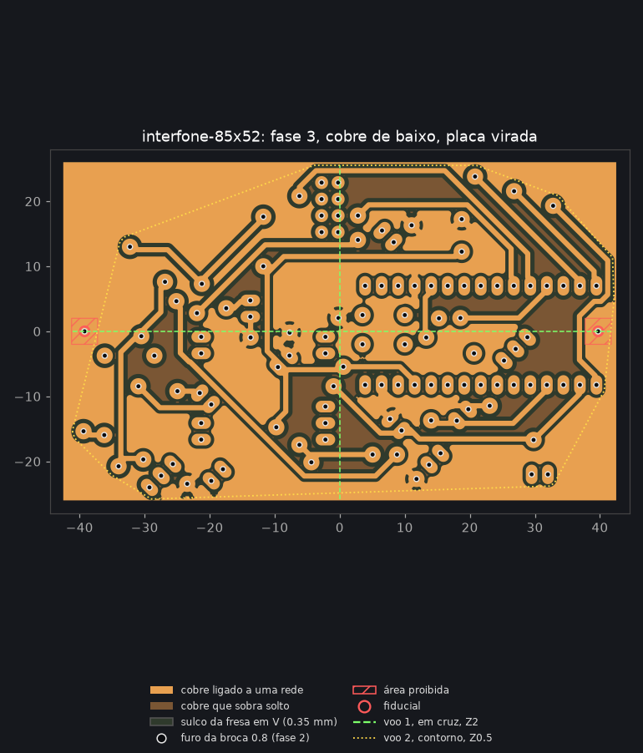
hardware/fabrication/gcode/preview-bottom.png
