aluisioalves123/rf-intercom/hardware/fabrication/gcode/preview-top.png

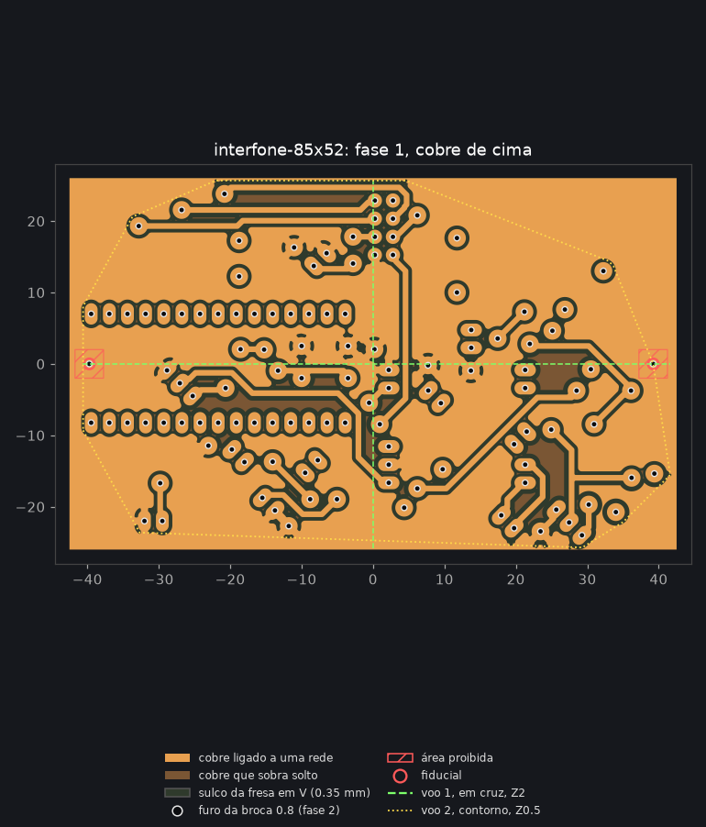
hardware/fabrication/gcode/preview-top.png
