aluisioalves123/rf-intercom/hardware/intercom.kicad_pcb

## KiCad design hardware/intercom.kicad_pcb (2026-10-19)

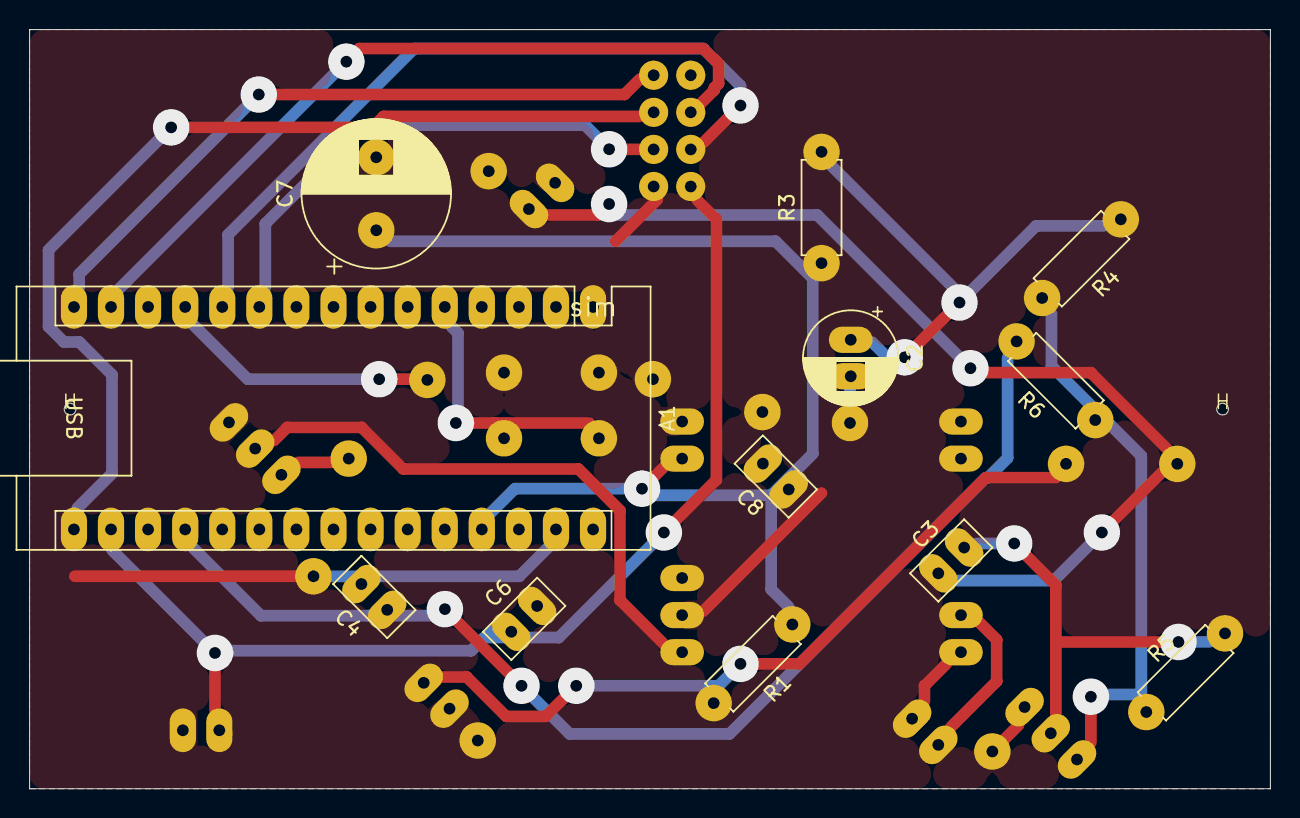
[picture p30: board intercom.kicad_pcb from above]

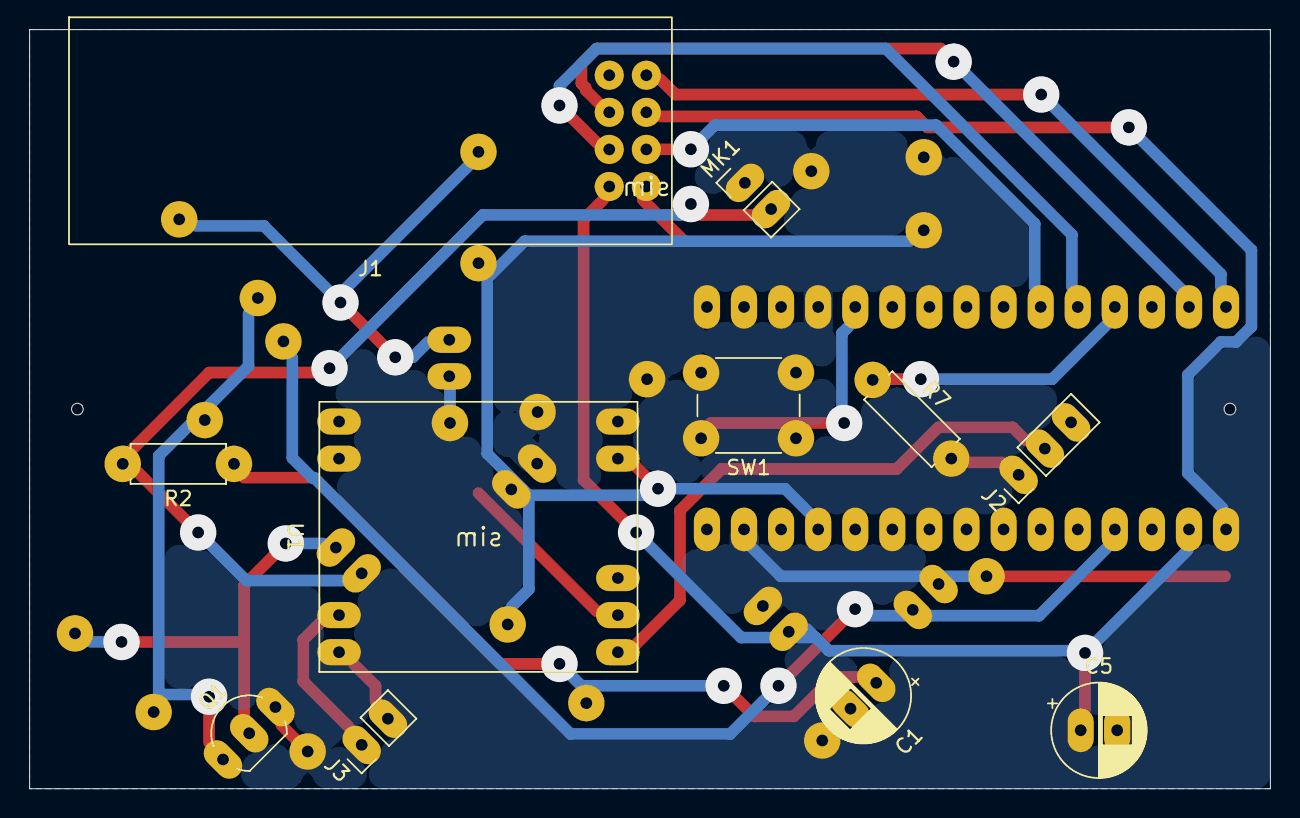
[picture p31: board intercom.kicad_pcb from below]

Board: 2 copper layers, 85.0 x 52.0 mm, 32 parts (11 on the bottom side), 20 nets.

Parts:
A1: Nano or LGT8F328P; Arduino_Nano
C1, C2, C5: 100uF; CP_Radial_D6.3mm_P2.50mm
C3: 100nF (104); C_Disc_D5.0mm_W2.5mm_P2.50mm
C4: 10nF (103); C_Disc_D5.0mm_W2.5mm_P2.50mm
C6, C8: 100nF; C_Disc_D5.0mm_W2.5mm_P2.50mm
C7: 1000uF; CP_Radial_D10.0mm_P5.00mm
H: Fiducial_Furo_0.8
H#2: Fiducial_Furo_0.8
J1: nRF24 PA+LNA; nRF24L01_PA_LNA_Module
J2: 5k pot (top, wiper, GND); PinHeader_1x03_P2.54mm_Vertical
J3: 8 ohm speaker; PinHeader_1x02_P2.54mm_Vertical
MK1: Electret; PinHeader_1x02_P2.54mm_Vertical
Q1: BC547; TO-92_Inline_Wide
R1: 1k; R_Axial_DIN0207_L6.3mm_D2.5mm_P7.62mm_Horizontal
R2, R4, R6: 2k2; R_Axial_DIN0207_L6.3mm_D2.5mm_P7.62mm_Horizontal
R3: 100; R_Axial_DIN0207_L6.3mm_D2.5mm_P7.62mm_Horizontal
R5: 1M; R_Axial_DIN0207_L6.3mm_D2.5mm_P7.62mm_Horizontal
R7: 33k; R_Axial_DIN0207_L6.3mm_D2.5mm_P7.62mm_Horizontal
SW1: Talk; SW_PUSH_6mm
U1: PAM8403; PAM8403_Module
VIAT1, VIAT2, VIAT3, VIAT4, VIAT5, VIAT6, VIAT7: via; via_termica

Connections:
+3V3: A1.17 (3V3), C5.1, C6.1, J1.2
+5V: A1.27 (+5V), C7.1, C8.1, R1.1, R3.1, U1.4
/AMP_IN: J2.2, U1.1
/AUDIO_PWM: A1.12 (D9), R7.1
/MIC_BIAS: C3.1, MK1.2 (+), R2.2
/MIC_OUT: A1.19 (A0), C4.1, R6.2
/MIC_SUPPLY: C1.1, R1.2, R2.1
/POT_TOP: J2.1, R7.2
/PREAMP_IN: C3.2, Q1.2 (B), R5.2
/PREAMP_OUT: Q1.1 (C), R4.2, R5.1, R6.1
/PREAMP_SUPPLY: C2.1, R3.2, R4.1
/PTT_BUTTON: A1.5 (D2), SW1.1
/RADIO_CE: A1.10 (D7), J1.3
/RADIO_CSN: A1.11 (D8), J1.4
/SPEAKER+: J3.1, U1.7
/SPEAKER-: J3.2, U1.6
/SPI_MISO: A1.15 (D12), J1.7
/SPI_MOSI: A1.14 (D11), J1.6
/SPI_SCK: A1.16 (D13), J1.5
GND: A1.4 (GND), A1.29 (GND), C1.2, C2.2, C4.2, C5.2, C6.2, C7.2, C8.2, J1.1, J2.3, MK1.1 (-), Q1.3 (E), SW1.2, U1.2, U1.5, VIAT1.1, VIAT2.1, VIAT3.1, VIAT4.1, VIAT5.1, VIAT6.1, VIAT7.1
